Fiat-Anw/FMU_schematic_design-from-STM32H743IIT6/FMU_Base_board_Design/AD&IO_Port.kicad_sch

## KiCad design FMU_Base_board_Design/AD&IO_Port.kicad_sch (2024-08-14)

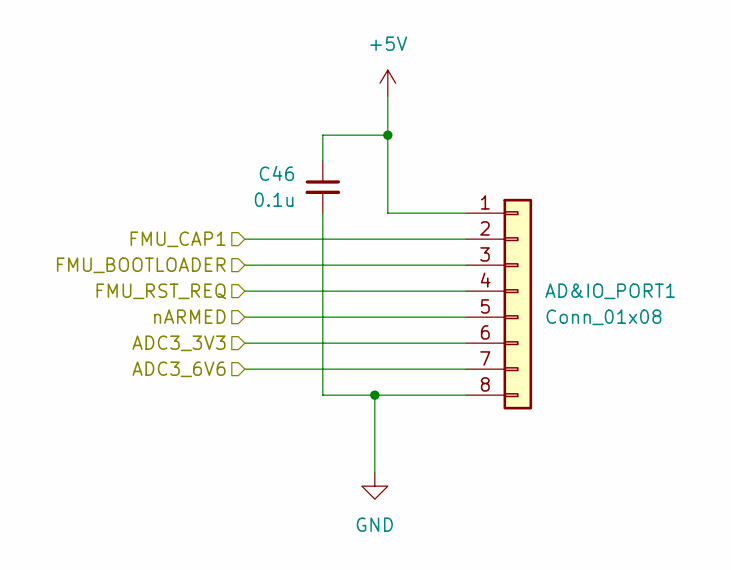
[picture p1: schematic AD&IO_Port.kicad_sch]

Parts:
AD&IO_PORT1: Conn_01x08; JST_GH_BM08B-GHS-TBT_1x08-1MP_P1.25mm_Vertical
C46: 0.1u; C_0402_1005Metric_Pad0.74x0.62mm_HandSolder

Connections:
+5V: AD&IO_PORT1.1, C46.1
ADC3_3V3: AD&IO_PORT1.6
ADC3_6V6: AD&IO_PORT1.7
FMU_BOOTLOADER: AD&IO_PORT1.3
FMU_CAP1: AD&IO_PORT1.2
FMU_RST_REQ: AD&IO_PORT1.4
GND: AD&IO_PORT1.8, C46.2
nARMED: AD&IO_PORT1.5
