Fiat-Anw/FMU_schematic_design-from-STM32H743IIT6/FMU_Base_board_Design/Barometer.kicad_sch

## KiCad design FMU_Base_board_Design/Barometer.kicad_sch (2024-08-14)

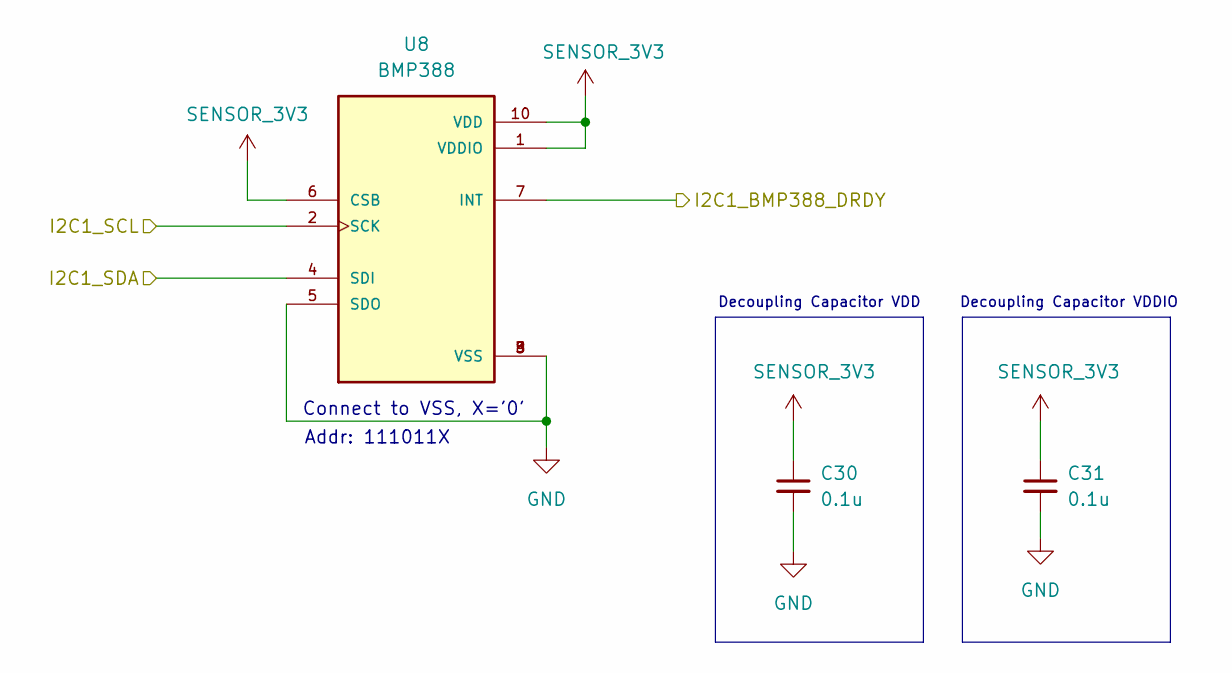
[picture p2: schematic Barometer.kicad_sch]

Parts:
C30, C31: 0.1u; C_0402_1005Metric_Pad0.74x0.62mm_HandSolder
U8: BMP388; PQFN50P200X200X80-10N; PARTREV 1.1

Connections:
GND: C30.2, C31.2, U8.3 (VSS), U8.5 (SDO), U8.8 (VSS), U8.9 (VSS)
I2C1_BMP388_DRDY: U8.7 (INT)
I2C1_SCL: U8.2 (SCK)
I2C1_SDA: U8.4 (SDI)
SENSOR_3V3: C30.1, C31.1, U8.1 (VDDIO), U8.6 (CSB), U8.10 (VDD)

Notes on the sheet:
Addr: 111011X
Connect to VSS, X='0'
Decoupling Capacitor VDD
Decoupling Capacitor VDDIO
