Fiat-Anw/FMU_schematic_design-from-STM32H743IIT6/FMU_Base_board_Design/CAN_Module1.kicad_sch

## KiCad design FMU_Base_board_Design/CAN_Module1.kicad_sch (2024-08-14)

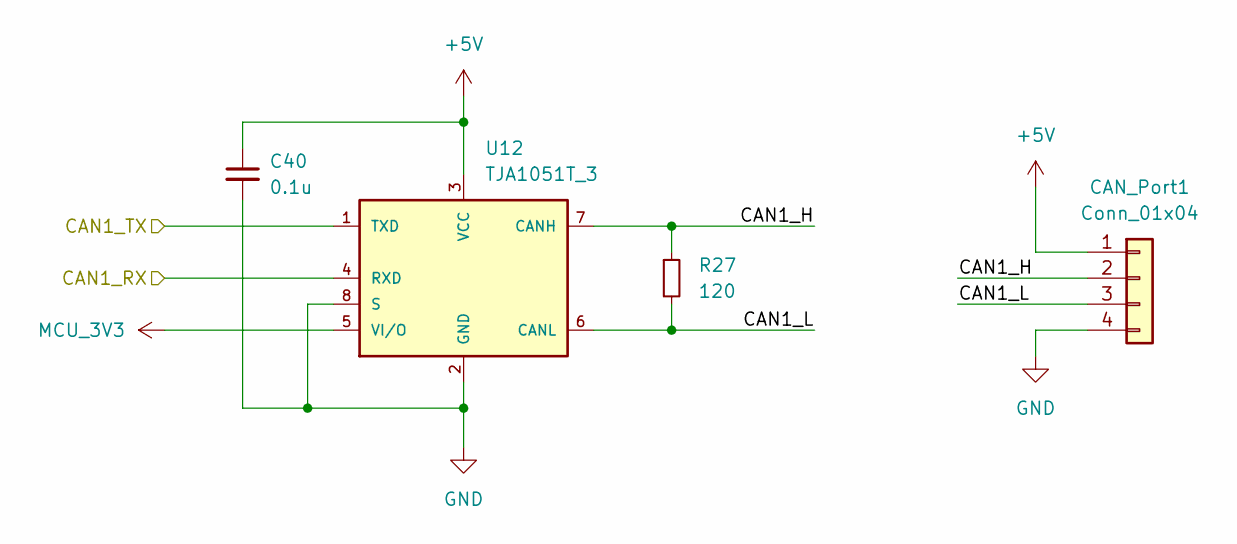
[picture p3: schematic CAN_Module1.kicad_sch]

Parts:
C40: 0.1u; C_0402_1005Metric_Pad0.74x0.62mm_HandSolder
CAN_Port1: Conn_01x04; JST_GH_BM04B-GHS-TBT_1x04-1MP_P1.25mm_Vertical
R27: 120; R_0402_1005Metric_Pad0.72x0.64mm_HandSolder
U12: TJA1051T_3; SOT96-1

Connections:
+5V: C40.1, CAN_Port1.1, U12.3 (VCC)
CAN1_H: CAN_Port1.2, R27.1, U12.7 (CANH)
CAN1_L: CAN_Port1.3, R27.2, U12.6 (CANL)
CAN1_RX: U12.4 (RXD)
CAN1_TX: U12.1 (TXD)
GND: C40.2, CAN_Port1.4, U12.2 (GND), U12.8 (S)
MCU_3V3: U12.5 (VI/O)
