Fiat-Anw/FMU_schematic_design-from-STM32H743IIT6/FMU_Base_board_Design/CAN_Module2.kicad_sch

## KiCad design FMU_Base_board_Design/CAN_Module2.kicad_sch (2024-08-14)

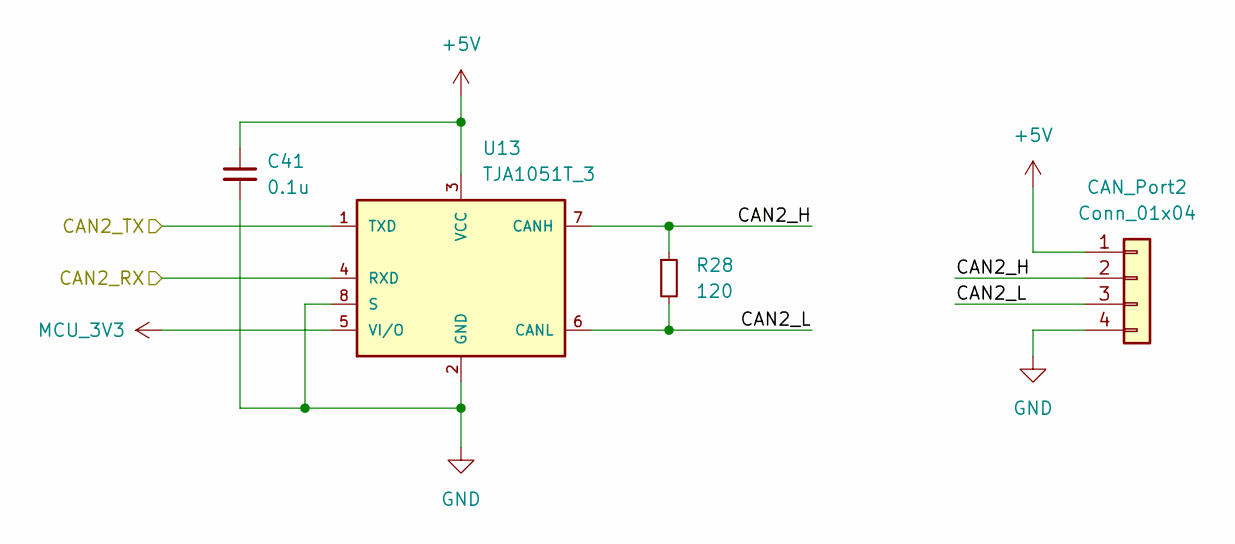
[picture p4: schematic CAN_Module2.kicad_sch]

Parts:
C41: 0.1u; C_0402_1005Metric_Pad0.74x0.62mm_HandSolder
CAN_Port2: Conn_01x04; JST_GH_BM04B-GHS-TBT_1x04-1MP_P1.25mm_Vertical
R28: 120; R_0402_1005Metric_Pad0.72x0.64mm_HandSolder
U13: TJA1051T_3; SOT96-1

Connections:
+5V: C41.1, CAN_Port2.1, U13.3 (VCC)
CAN2_H: CAN_Port2.2, R28.1, U13.7 (CANH)
CAN2_L: CAN_Port2.3, R28.2, U13.6 (CANL)
CAN2_RX: U13.4 (RXD)
CAN2_TX: U13.1 (TXD)
GND: C41.2, CAN_Port2.4, U13.2 (GND), U13.8 (S)
MCU_3V3: U13.5 (VI/O)
