Fiat-Anw/FMU_schematic_design-from-STM32H743IIT6/FMU_Base_board_Design/FMU_Debug.kicad_sch

## KiCad design FMU_Base_board_Design/FMU_Debug.kicad_sch (2024-08-14)

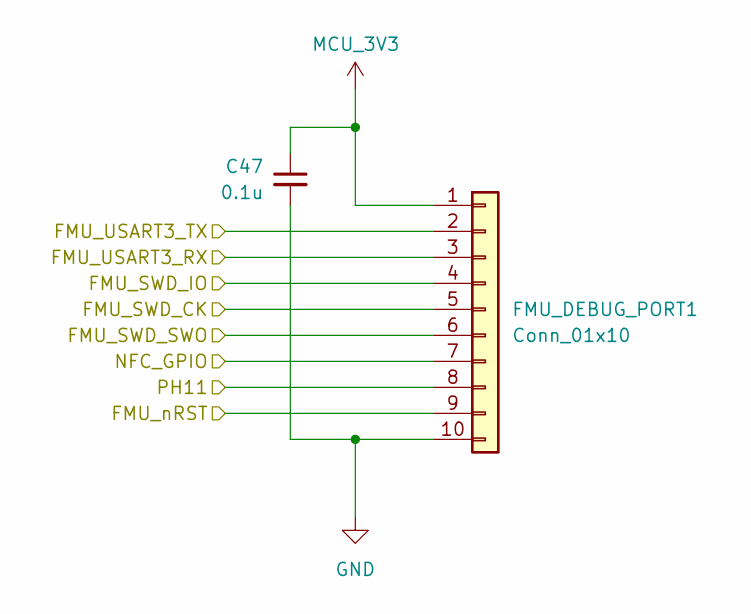
[picture p5: schematic FMU_Debug.kicad_sch]

Parts:
C47: 0.1u; C_0402_1005Metric_Pad0.74x0.62mm_HandSolder
FMU_DEBUG_PORT1: Conn_01x10; JST_SH_SM10B-SRSS-TB_1x10-1MP_P1.00mm_Horizontal

Connections:
FMU_SWD_CK: FMU_DEBUG_PORT1.5
FMU_SWD_IO: FMU_DEBUG_PORT1.4
FMU_SWD_SWO: FMU_DEBUG_PORT1.6
FMU_USART3_RX: FMU_DEBUG_PORT1.3
FMU_USART3_TX: FMU_DEBUG_PORT1.2
FMU_nRST: FMU_DEBUG_PORT1.9
GND: C47.2, FMU_DEBUG_PORT1.10
MCU_3V3: C47.1, FMU_DEBUG_PORT1.1
NFC_GPIO: FMU_DEBUG_PORT1.7
PH11: FMU_DEBUG_PORT1.8
