Fiat-Anw/FMU_schematic_design-from-STM32H743IIT6/FMU_Base_board_Design/FMU_PPM_IN_PWM.kicad_sch

## KiCad design FMU_Base_board_Design/FMU_PPM_IN_PWM.kicad_sch (2024-08-14)

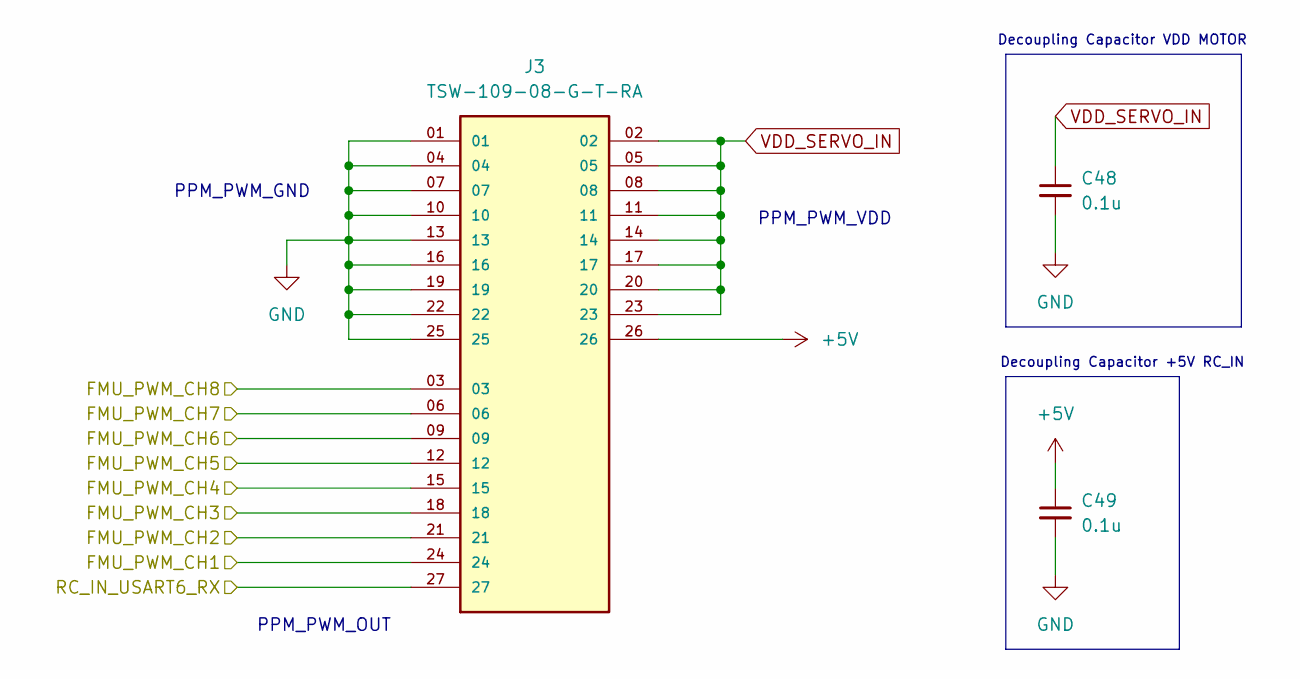
[picture p6: schematic FMU_PPM_IN_PWM.kicad_sch]

Parts:
C48, C49: 0.1u; C_0402_1005Metric_Pad0.74x0.62mm_HandSolder
J3: TSW-109-08-G-T-RA; SAMTEC_TSW-109-08-G-T-RA; PARTREV R

Connections:
+5V: C49.1, J3.26
FMU_PWM_CH1: J3.24
FMU_PWM_CH2: J3.21
FMU_PWM_CH3: J3.18
FMU_PWM_CH4: J3.15
FMU_PWM_CH5: J3.12
FMU_PWM_CH6: J3.09
FMU_PWM_CH7: J3.06
FMU_PWM_CH8: J3.03
GND: C48.2, C49.2, J3.01, J3.04, J3.07, J3.10, J3.13, J3.16, J3.19, J3.22, J3.25
RC_IN_USART6_RX: J3.27
VDD_SERVO_IN: C48.1, J3.02, J3.05, J3.08, J3.11, J3.14, J3.17, J3.20, J3.23

Notes on the sheet:
PPM_PWM_OUT
Decoupling Capacitor +5V RC_IN
PPM_PWM_VDD
PPM_PWM_GND
Decoupling Capacitor VDD MOTOR
