Fiat-Anw/FMU_schematic_design-from-STM32H743IIT6/FMU_Base_board_Design/FMU_PWM.kicad_sch

## KiCad design FMU_Base_board_Design/FMU_PWM.kicad_sch (2024-08-14)

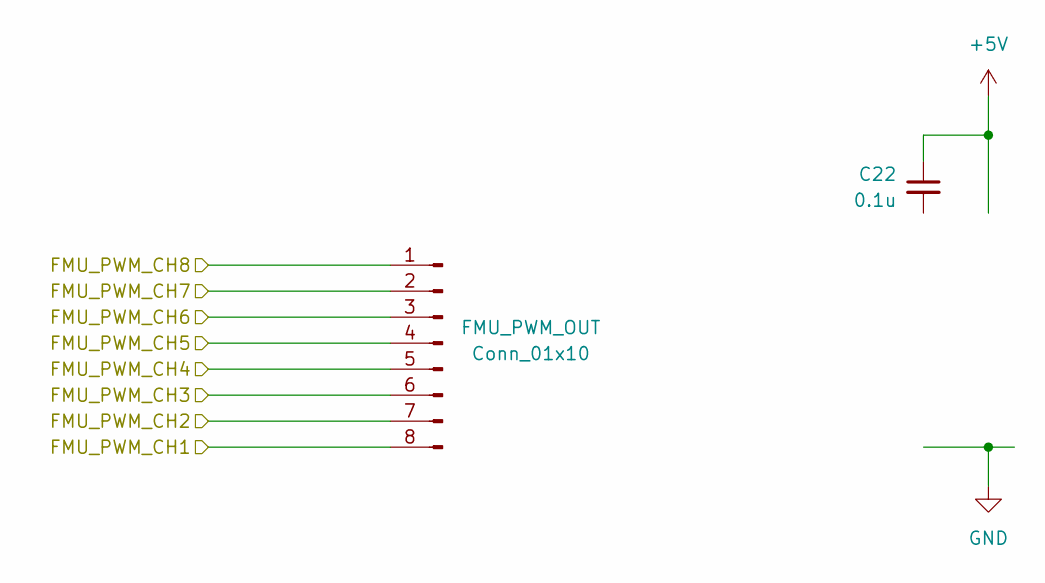
[picture p7: schematic FMU_PWM.kicad_sch]

Parts:
C22: 0.1u
FMU_PWM_OUT: Conn_01x10

Connections:
+5V: C22.1
FMU_PWM_CH1: FMU_PWM_OUT.8
FMU_PWM_CH2: FMU_PWM_OUT.7
FMU_PWM_CH3: FMU_PWM_OUT.6
FMU_PWM_CH4: FMU_PWM_OUT.5
FMU_PWM_CH5: FMU_PWM_OUT.4
FMU_PWM_CH6: FMU_PWM_OUT.3
FMU_PWM_CH7: FMU_PWM_OUT.2
FMU_PWM_CH8: FMU_PWM_OUT.1
