Fiat-Anw/FMU_schematic_design-from-STM32H743IIT6/FMU_Base_board_Design/FMU_Power_Supply.kicad_sch

## KiCad design FMU_Base_board_Design/FMU_Power_Supply.kicad_sch (2024-08-14)

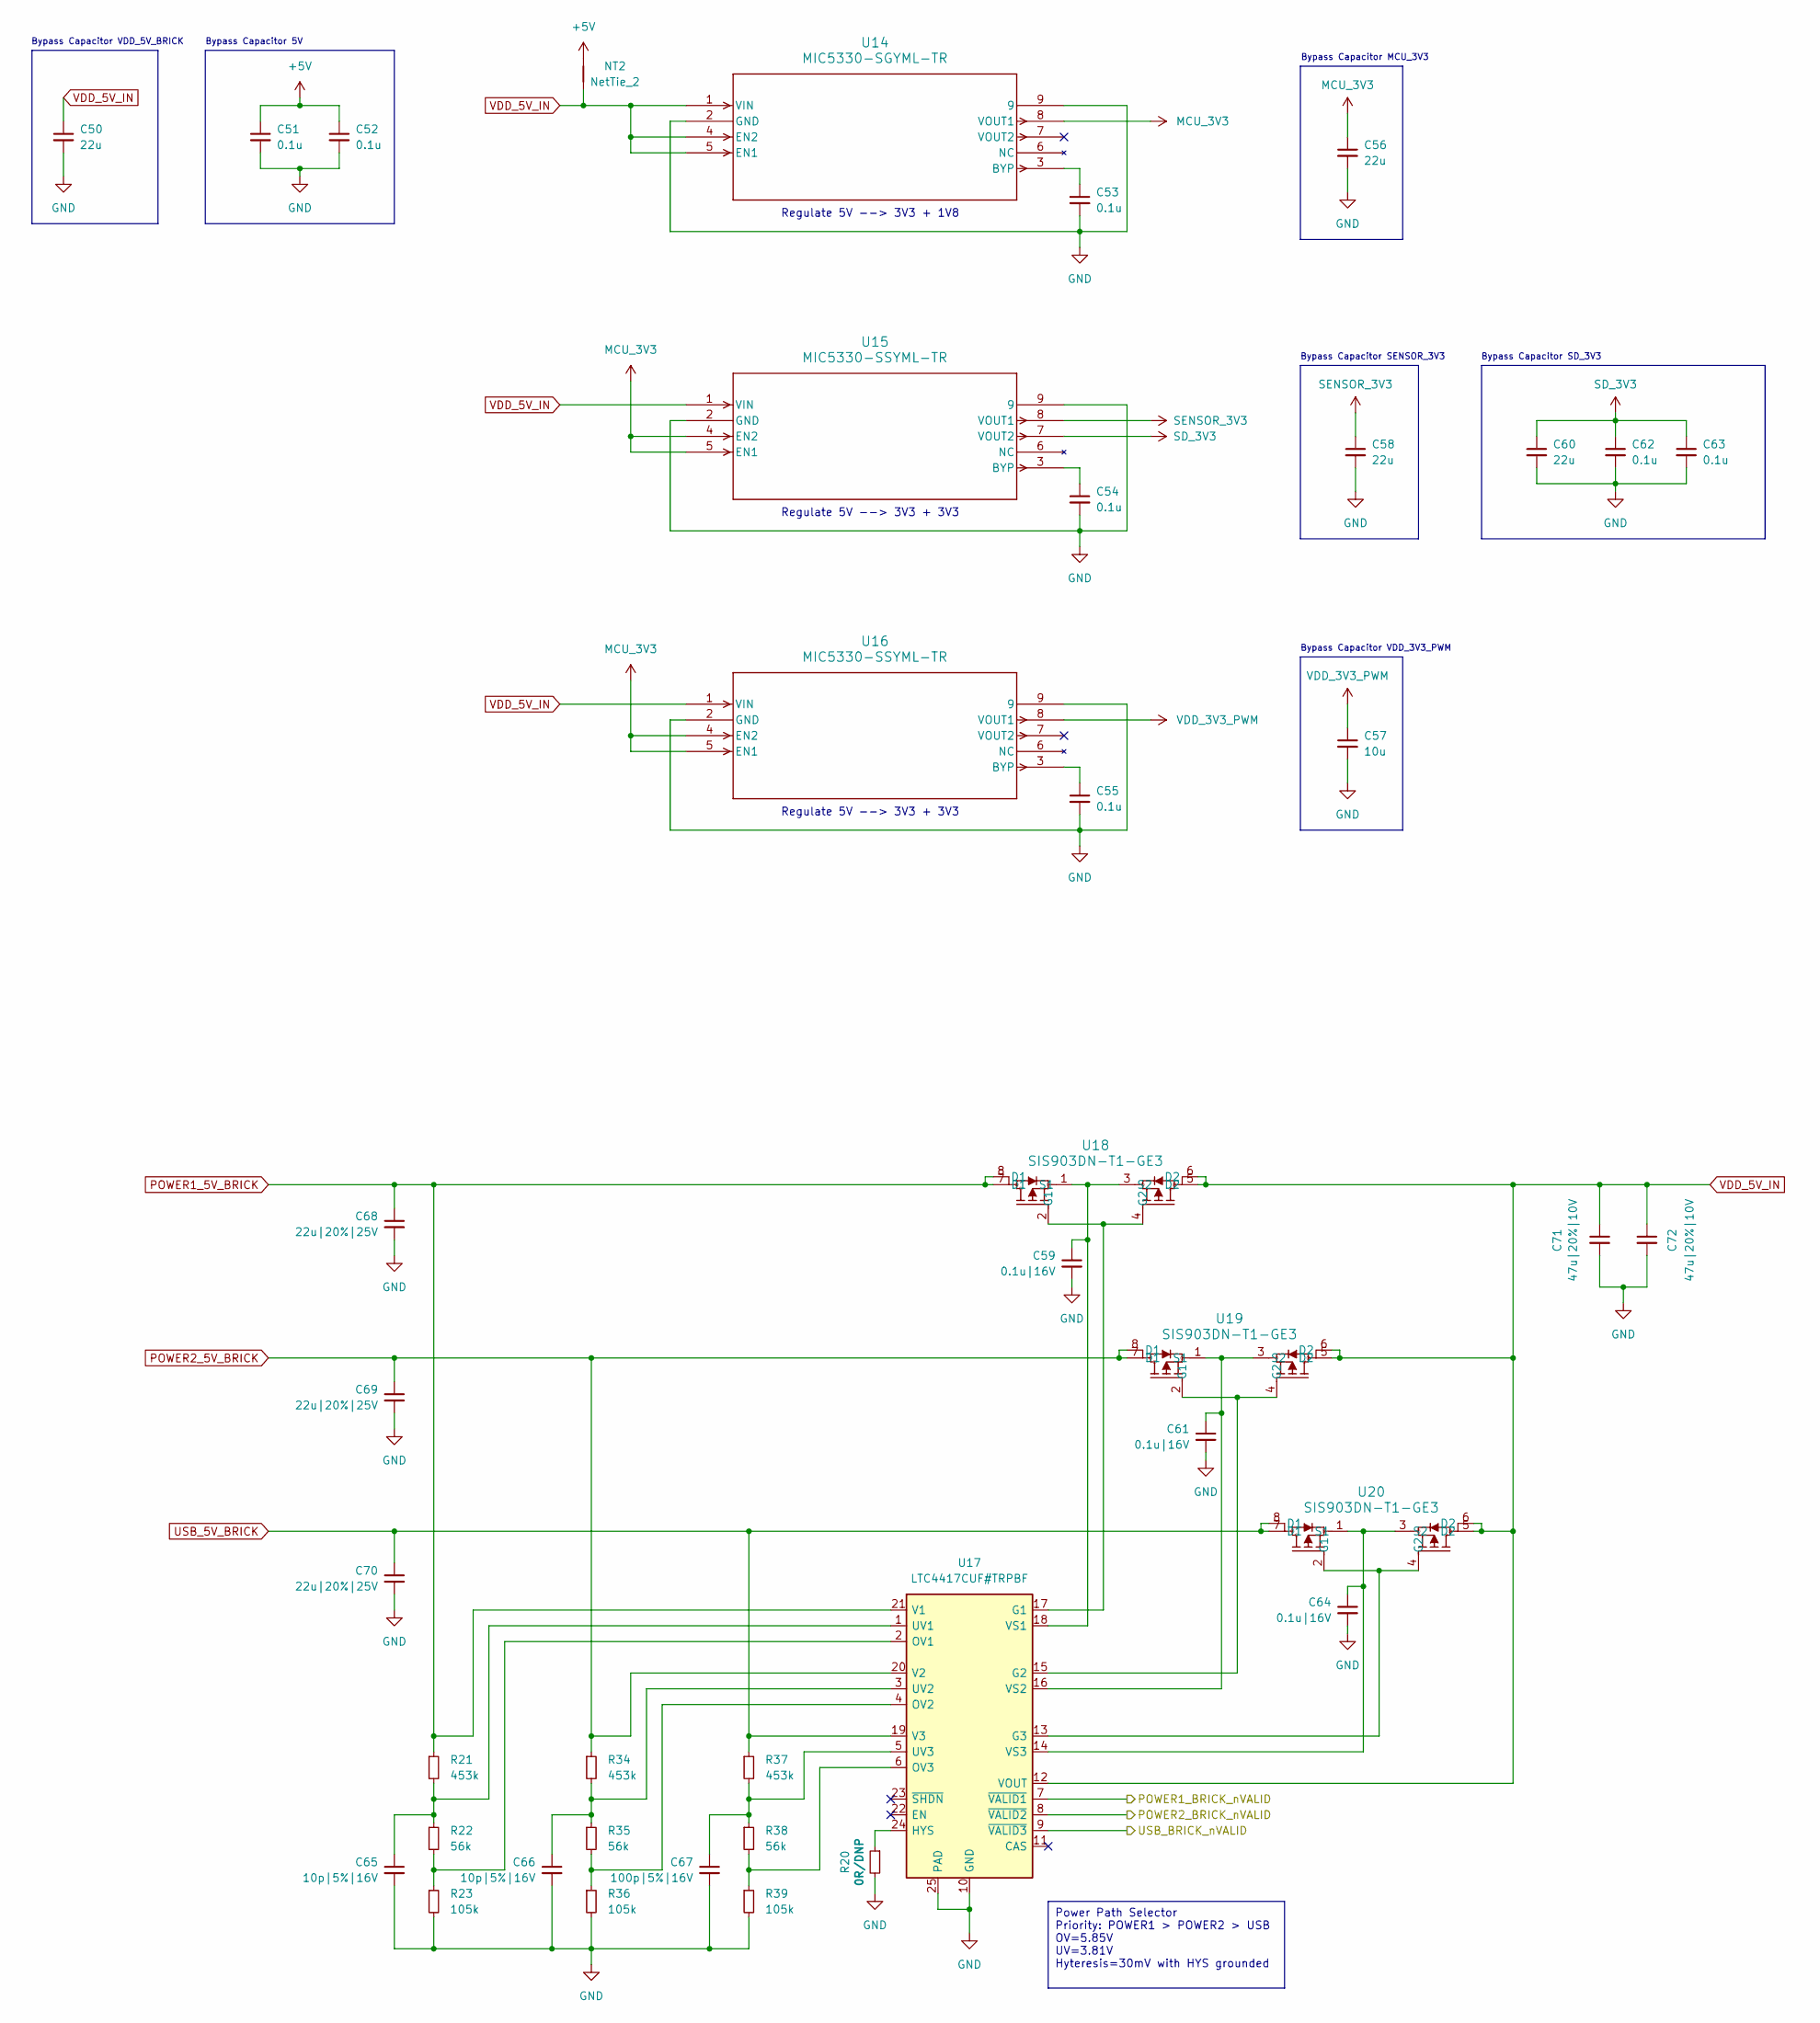
[picture p8: schematic FMU_Power_Supply.kicad_sch]

Parts:
C50, C56, C58, C60: 22u; C_0603_1608Metric_Pad1.08x0.95mm_HandSolder
C51, C52, C53, C54, C55, C62, C63: 0.1u; C_0402_1005Metric_Pad0.74x0.62mm_HandSolder
C57: 10u; C_0402_1005Metric_Pad0.74x0.62mm_HandSolder
C59, C61, C64: 0.1u|16V; C_0402_1005Metric_Pad0.74x0.62mm_HandSolder
C65, C66: 10p|5%|16V; C_0402_1005Metric_Pad0.74x0.62mm_HandSolder
C67: 100p|5%|16V; C_0402_1005Metric_Pad0.74x0.62mm_HandSolder
C68, C69, C70: 22u|20%|25V; C_0603_1608Metric_Pad1.08x0.95mm_HandSolder
C71, C72: 47u|20%|10V; C_0805_2012Metric_Pad1.18x1.45mm_HandSolder
NT2: NetTie_2; NetTie-2_SMD_Pad2.0mm
R20: 0R/DNP; R_0402_1005Metric_Pad0.72x0.64mm_HandSolder
R21, R34, R37: 453k; R_0402_1005Metric_Pad0.72x0.64mm_HandSolder
R22, R35, R38: 56k; R_0402_1005Metric_Pad0.72x0.64mm_HandSolder
R23, R36, R39: 105k; R_0402_1005Metric_Pad0.72x0.64mm_HandSolder
U14: MIC5330-SGYML-TR; MLF-8_ML_MCH
U15, U16: MIC5330-SSYML-TR; MLF-8_ML_MCH
U17: LTC4417CUF#TRPBF; QFN-24-1EP_4x4mm_P0.5mm_EP2.6x2.6mm
U18, U19, U20: SIS903DN-T1-GE3; MOSFET_DN-T1-GE3_VIS

Connections:
+5V: C51.1, C52.1, NT2.1
GND: C50.2, C51.2, C52.2, C53.2, C54.2, C55.2, C56.2, C57.2, C58.2, C59.2, C60.2, C61.2, C62.2, C63.2, C64.2, C65.2, C66.2, C67.2, C68.2, C69.2, C70.2, C71.2, C72.2, R20.2, R23.2, R36.2, R39.2, U14.2 (GND), U14.9, U15.2 (GND), U15.9, U16.2 (GND), U16.9, U17.10 (GND), U17.25 (PAD)
MCU_3V3: C56.1, U14.8 (VOUT1), U15.4 (EN2), U15.5 (EN1), U16.4 (EN2), U16.5 (EN1)
unnamed: C53.1, U14.3 (BYP)
unnamed: C54.1, U15.3 (BYP)
unnamed: C55.1, U16.3 (BYP)
unnamed: C59.1, U17.18 (VS1), U18.1 (S1), U18.3 (S2)
unnamed: C61.1, U17.16 (VS2), U19.1 (S1), U19.3 (S2)
unnamed: C64.1, U17.14 (VS3), U20.1 (S1), U20.3 (S2)
unnamed: C65.1, R21.2, R22.1, U17.1 (UV1)
unnamed: C66.1, R34.2, R35.1, U17.3 (UV2)
unnamed: C67.1, R37.2, R38.1, U17.5 (UV3)
unnamed: R20.1, U17.24 (HYS)
unnamed: R22.2, R23.1, U17.2 (OV1)
unnamed: R35.2, R36.1, U17.4 (OV2)
unnamed: R38.2, R39.1, U17.6 (OV3)
unnamed: U17.13 (G3), U20.2 (G1), U20.4 (G2)
unnamed: U17.15 (G2), U19.2 (G1), U19.4 (G2)
unnamed: U17.17 (G1), U18.2 (G1), U18.4 (G2)
POWER1_5V_BRICK: C68.1, R21.1, U17.21 (V1), U18.7 (D1), U18.8 (D1)
POWER1_BRICK_nVALID: U17.7 (~VALID1)
POWER2_5V_BRICK: C69.1, R34.1, U17.20 (V2), U19.7 (D1), U19.8 (D1)
POWER2_BRICK_nVALID: U17.8 (~VALID2)
SD_3V3: C60.1, C62.1, C63.1, U15.7 (VOUT2)
SENSOR_3V3: C58.1, U15.8 (VOUT1)
USB_5V_BRICK: C70.1, R37.1, U17.19 (V3), U20.7 (D1), U20.8 (D1)
USB_BRICK_nVALID: U17.9 (~VALID3)
VDD_3V3_PWM: C57.1, U16.8 (VOUT1)
VDD_5V_IN: C50.1, C71.1, C72.1, NT2.2, U14.1 (VIN), U14.4 (EN2), U14.5 (EN1), U15.1 (VIN), U16.1 (VIN), U17.12 (VOUT), U18.5 (D2), U18.6 (D2), U19.5 (D2), U19.6 (D2), U20.5 (D2), U20.6 (D2)

Notes on the sheet:
Power Path Selector Priority: POWER1 > POWER2 > USB OV=5.85V UV=3.81V Hyteresis=30mV with HYS grounded
Bypass Capacitor MCU_3V3
Bypass Capacitor VDD_5V_BRICK
Bypass Capacitor 5V
Bypass Capacitor SD_3V3
Bypass Capacitor VDD_3V3_PWM
Bypass Capacitor SENSOR_3V3
Regulate 5V --> 3V3 + 1V8
Regulate 5V --> 3V3 + 3V3
