Fiat-Anw/FMU_schematic_design-from-STM32H743IIT6/FMU_Base_board_Design/FRAM.kicad_sch

## KiCad design FMU_Base_board_Design/FRAM.kicad_sch (2024-08-14)

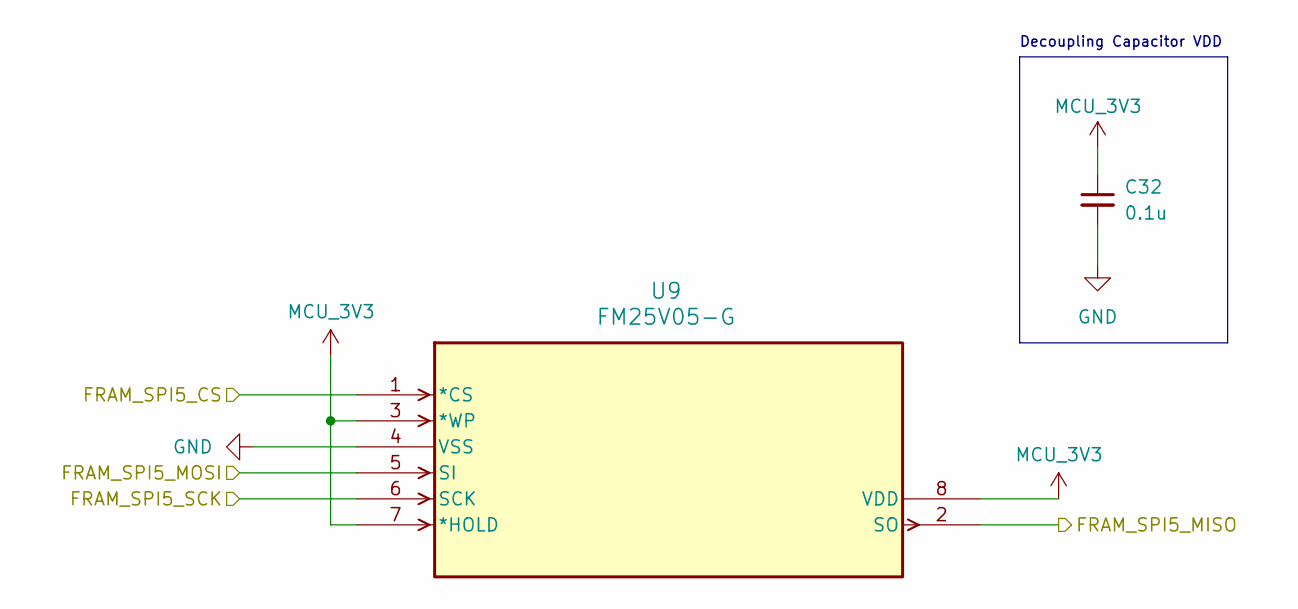
[picture p9: schematic FRAM.kicad_sch]

Parts:
C32: 0.1u; C_0402_1005Metric_Pad0.74x0.62mm_HandSolder
U9: FM25V05-G; SOIC-8

Connections:
FRAM_SPI5_CS: U9.1 (*CS)
FRAM_SPI5_MISO: U9.2 (SO)
FRAM_SPI5_MOSI: U9.5 (SI)
FRAM_SPI5_SCK: U9.6 (SCK)
GND: C32.2, U9.4 (VSS)
MCU_3V3: C32.1, U9.3 (*WP), U9.7 (*HOLD), U9.8 (VDD)

Notes on the sheet:
Decoupling Capacitor VDD
