Fiat-Anw/FMU_schematic_design-from-STM32H743IIT6/FMU_Base_board_Design/GPS_Module1.kicad_sch

## KiCad design FMU_Base_board_Design/GPS_Module1.kicad_sch (2024-08-14)

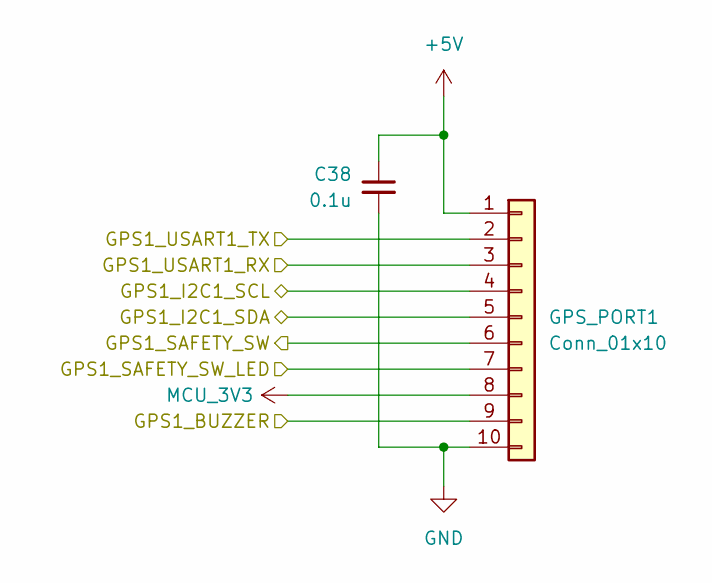
[picture p10: schematic GPS_Module1.kicad_sch]

Parts:
C38: 0.1u; C_0402_1005Metric_Pad0.74x0.62mm_HandSolder
GPS_PORT1: Conn_01x10; JST_GH_BM10B-GHS-TBT_1x10-1MP_P1.25mm_Vertical

Connections:
+5V: C38.1, GPS_PORT1.1
GND: C38.2, GPS_PORT1.10
GPS1_BUZZER: GPS_PORT1.9
GPS1_I2C1_SCL: GPS_PORT1.4
GPS1_I2C1_SDA: GPS_PORT1.5
GPS1_SAFETY_SW: GPS_PORT1.6
GPS1_SAFETY_SW_LED: GPS_PORT1.7
GPS1_USART1_RX: GPS_PORT1.3
GPS1_USART1_TX: GPS_PORT1.2
MCU_3V3: GPS_PORT1.8
