Fiat-Anw/FMU_schematic_design-from-STM32H743IIT6/FMU_Base_board_Design/GPS_Module2.kicad_sch

## KiCad design FMU_Base_board_Design/GPS_Module2.kicad_sch (2024-08-14)

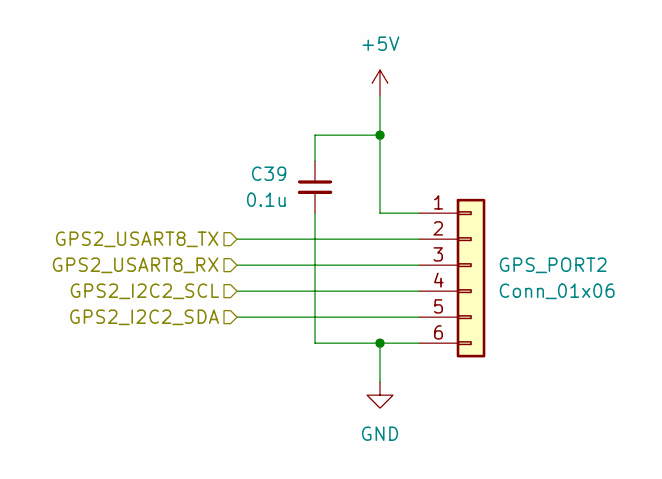
[picture p11: schematic GPS_Module2.kicad_sch]

Parts:
C39: 0.1u; C_0402_1005Metric_Pad0.74x0.62mm_HandSolder
GPS_PORT2: Conn_01x06; JST_GH_BM06B-GHS-TBT_1x06-1MP_P1.25mm_Vertical

Connections:
+5V: C39.1, GPS_PORT2.1
GND: C39.2, GPS_PORT2.6
GPS2_I2C2_SCL: GPS_PORT2.4
GPS2_I2C2_SDA: GPS_PORT2.5
GPS2_USART8_RX: GPS_PORT2.3
GPS2_USART8_TX: GPS_PORT2.2
