Fiat-Anw/FMU_schematic_design-from-STM32H743IIT6/FMU_Base_board_Design/I2C_Port.kicad_sch

## KiCad design FMU_Base_board_Design/I2C_Port.kicad_sch (2024-08-14)

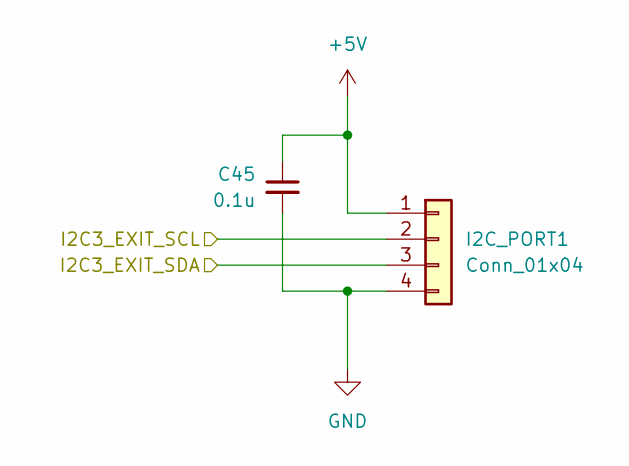
[picture p12: schematic I2C_Port.kicad_sch]

Parts:
C45: 0.1u; C_0402_1005Metric_Pad0.74x0.62mm_HandSolder
I2C_PORT1: Conn_01x04; JST_GH_BM04B-GHS-TBT_1x04-1MP_P1.25mm_Vertical

Connections:
+5V: C45.1, I2C_PORT1.1
GND: C45.2, I2C_PORT1.4
I2C3_EXIT_SCL: I2C_PORT1.2
I2C3_EXIT_SDA: I2C_PORT1.3
