Fiat-Anw/FMU_schematic_design-from-STM32H743IIT6/FMU_Base_board_Design/IMU.kicad_sch

## KiCad design FMU_Base_board_Design/IMU.kicad_sch (2024-08-14)

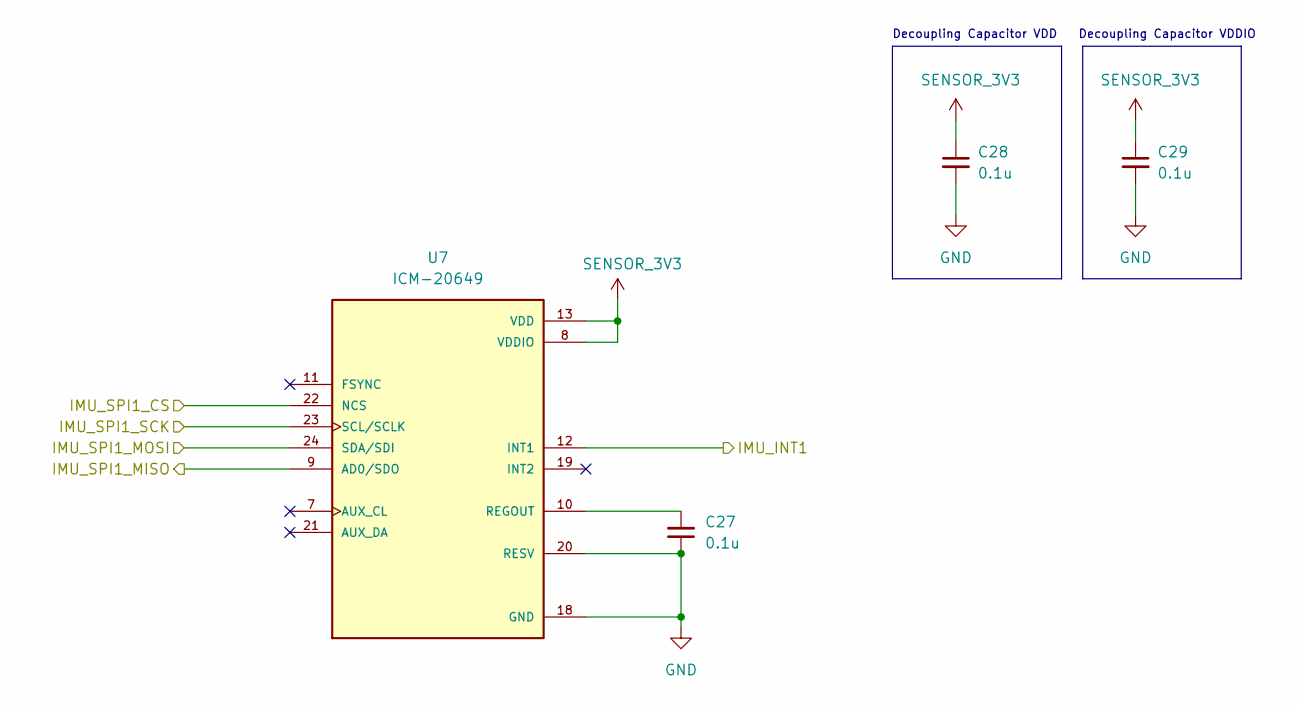
[picture p13: schematic IMU.kicad_sch]

Parts:
C27, C28, C29: 0.1u; C_0402_1005Metric_Pad0.74x0.62mm_HandSolder
U7: ICM-20649; QFN40P300X300X95-24N

Connections:
GND: C27.1, C28.2, C29.2, U7.18 (GND), U7.20 (RESV)
IMU_INT1: U7.12 (INT1)
IMU_SPI1_CS: U7.22 (NCS)
IMU_SPI1_MISO: U7.9 (AD0/SDO)
IMU_SPI1_MOSI: U7.24 (SDA/SDI)
IMU_SPI1_SCK: U7.23 (SCL/SCLK)
unnamed: C27.2, U7.10 (REGOUT)
SENSOR_3V3: C28.1, C29.1, U7.8 (VDDIO), U7.13 (VDD)

Notes on the sheet:
Decoupling Capacitor VDD
Decoupling Capacitor VDDIO
