Fiat-Anw/FMU_schematic_design-from-STM32H743IIT6/FMU_Base_board_Design/MCU.kicad_sch

## KiCad design FMU_Base_board_Design/MCU.kicad_sch (2024-08-14)

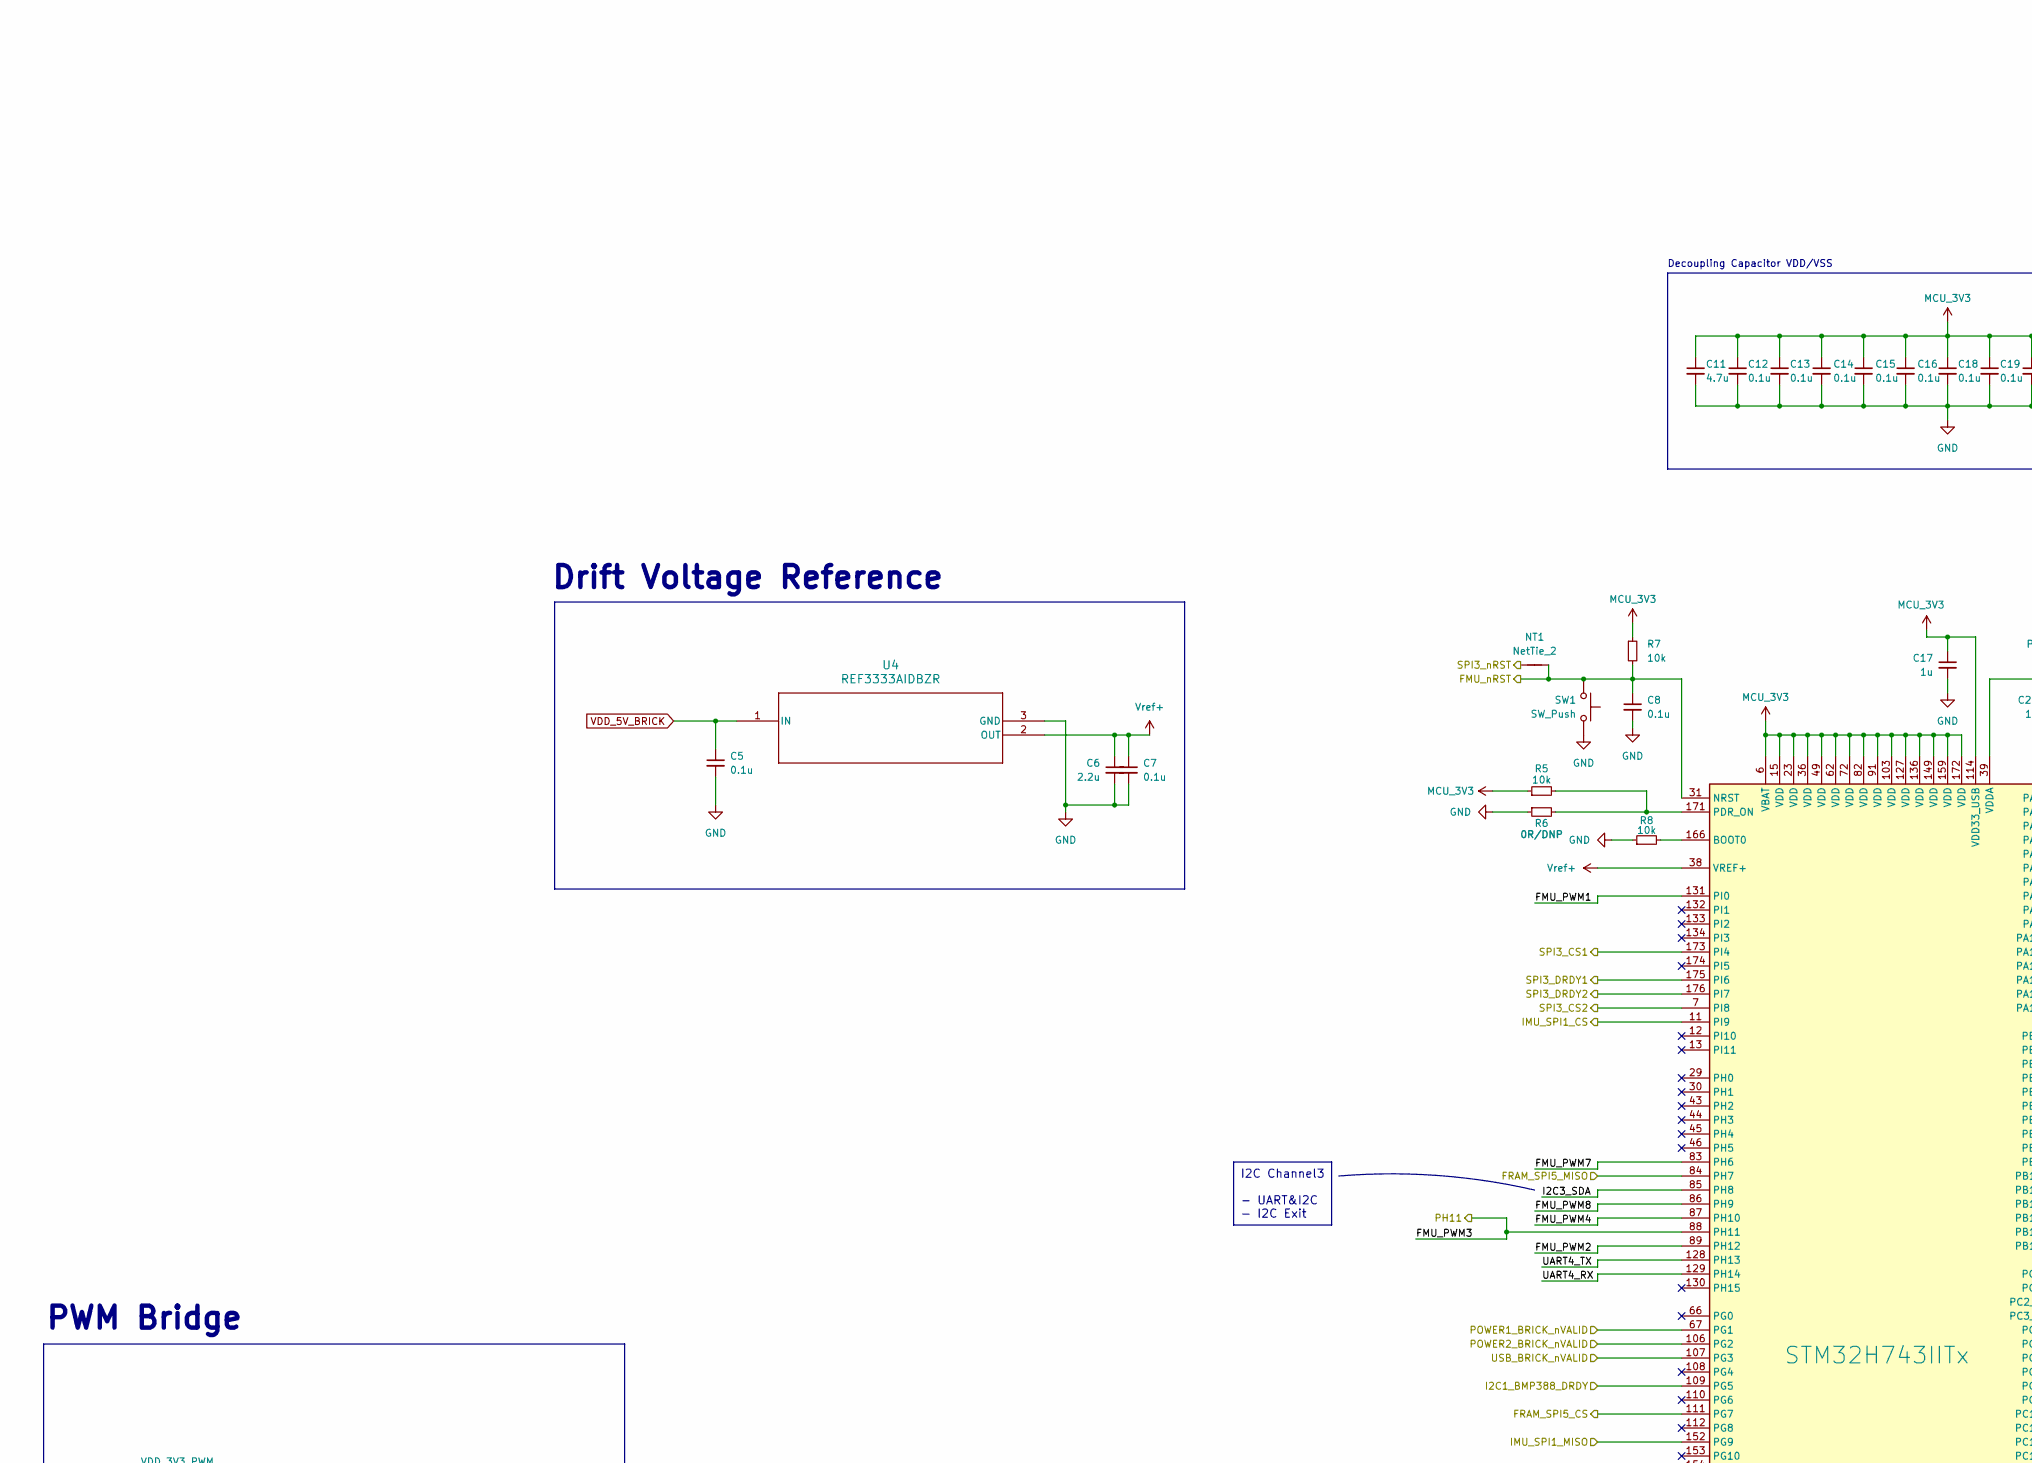
[picture p14: schematic MCU.kicad_sch, part in row 1, column 1]

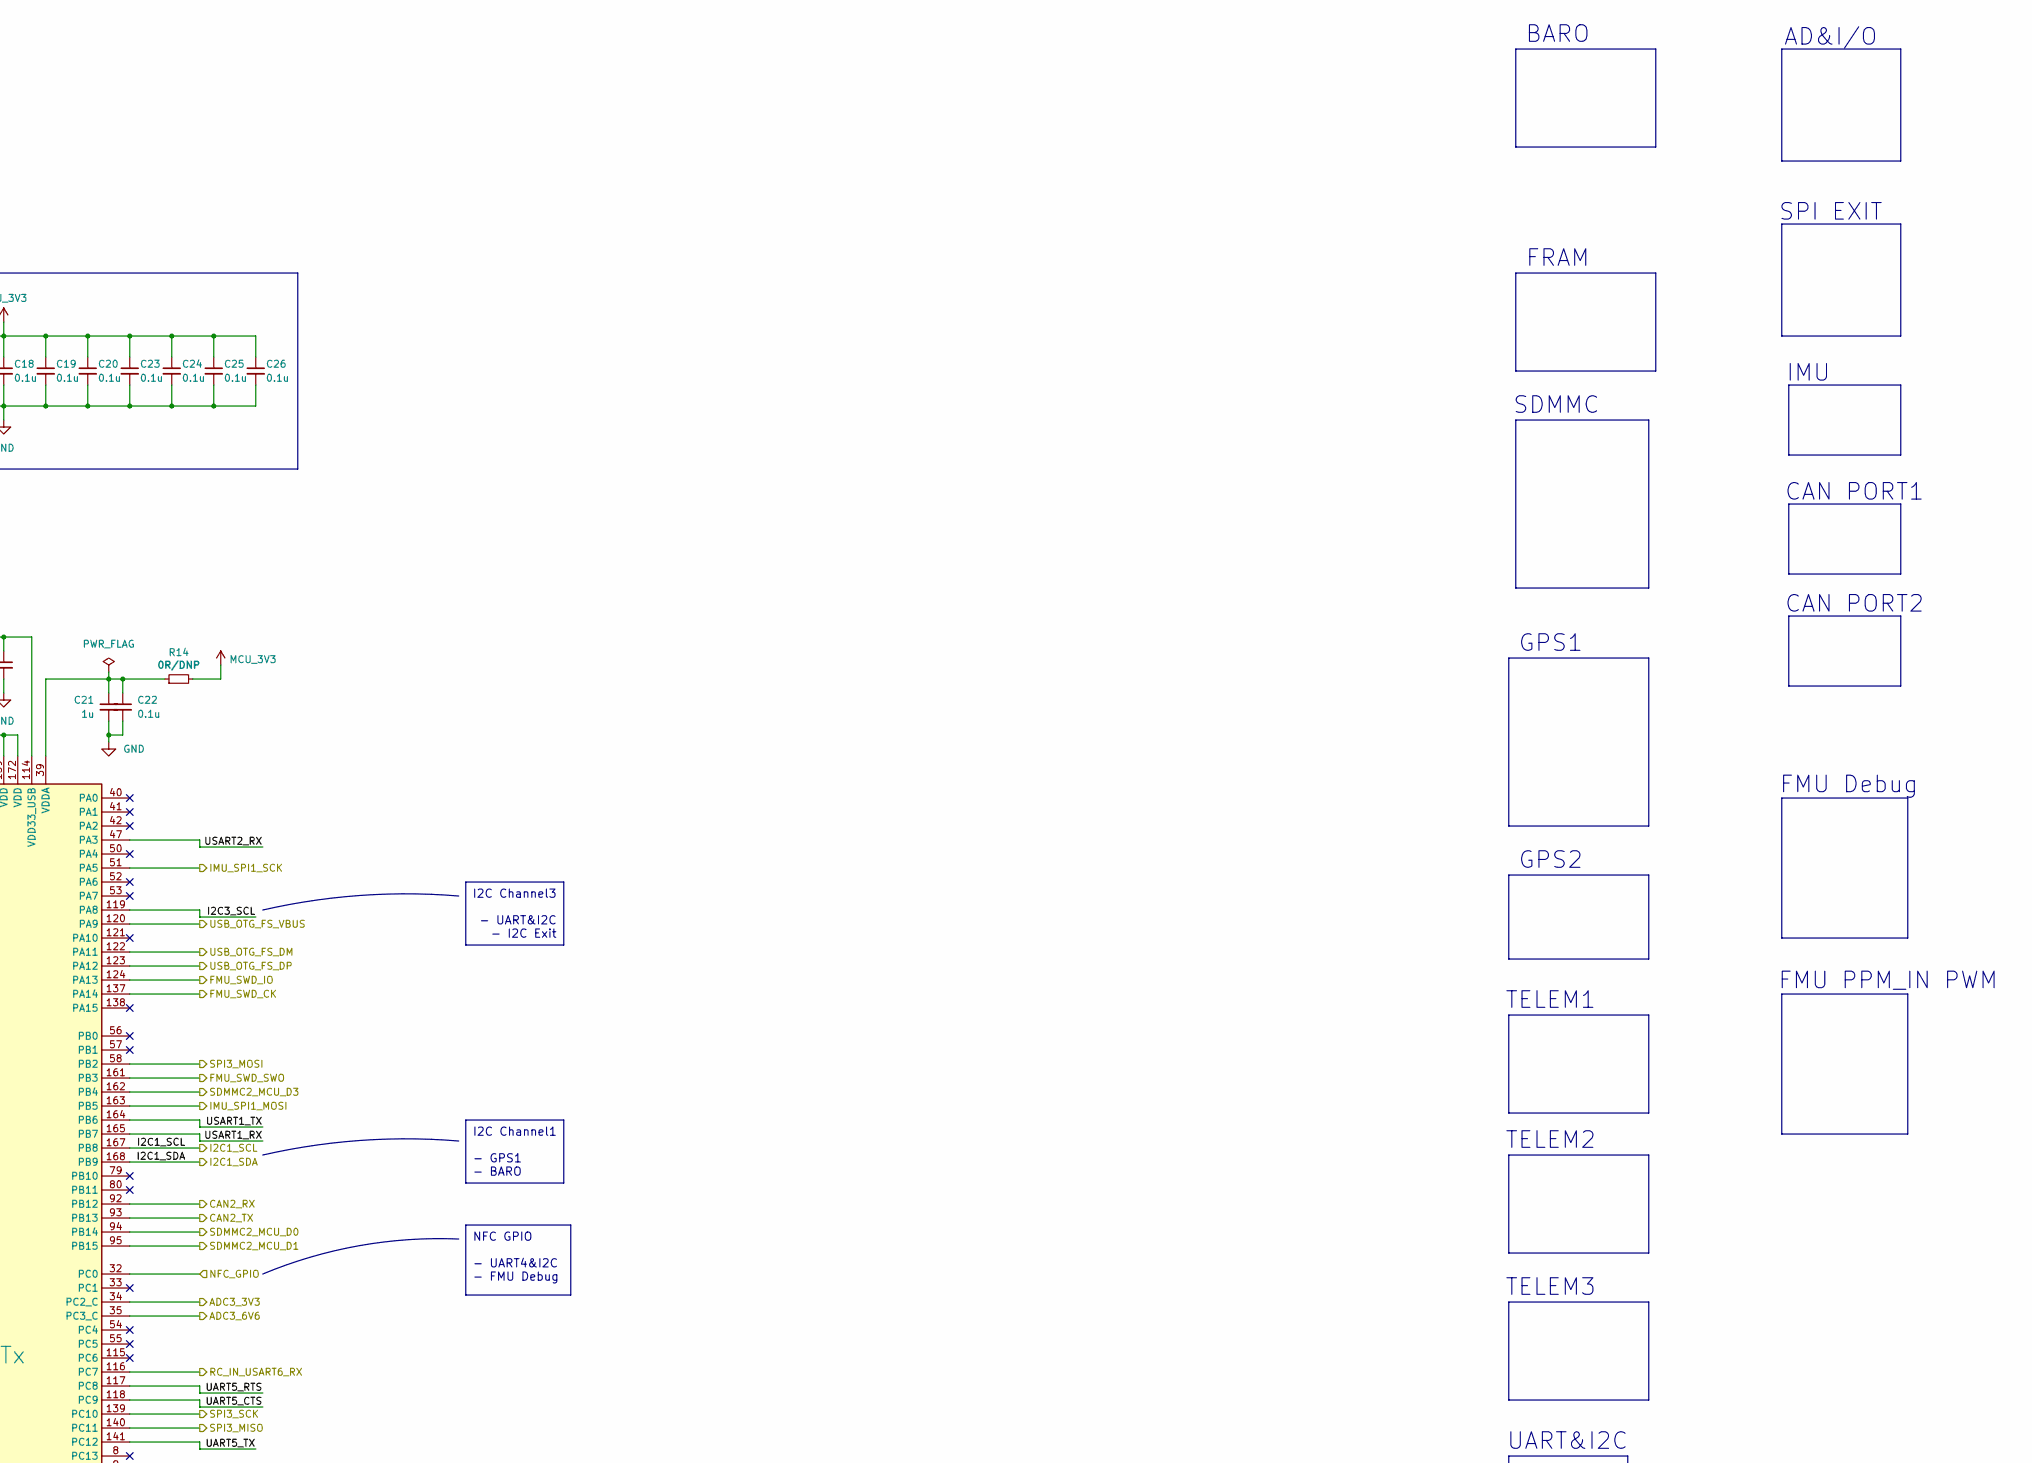
[picture p15: schematic MCU.kicad_sch, part in row 1, column 2]

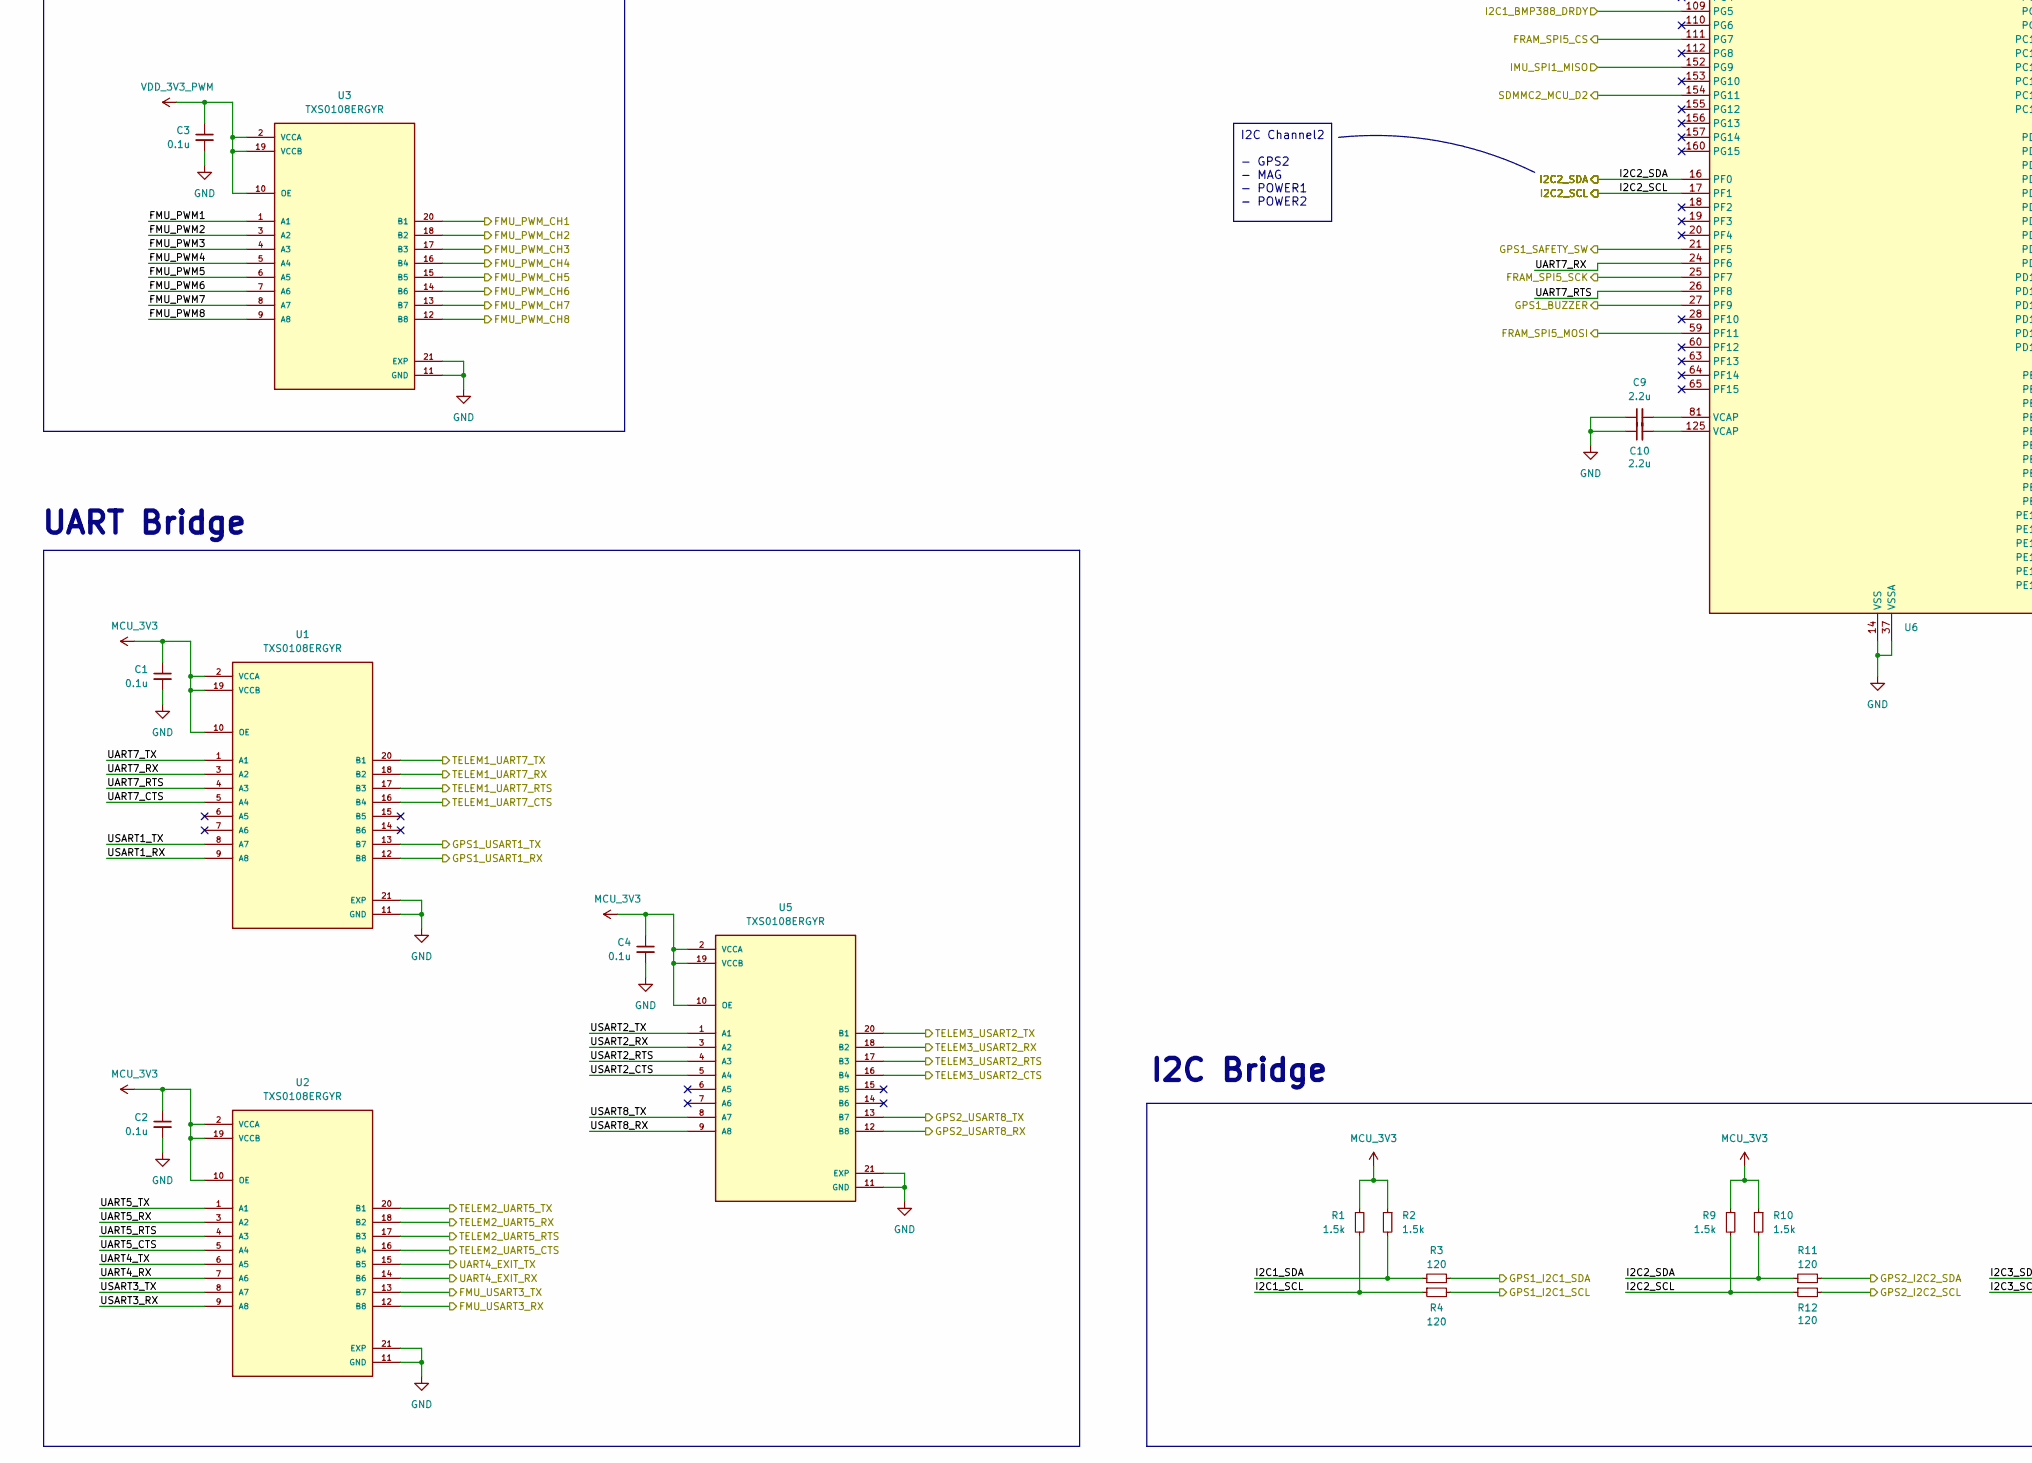
[picture p16: schematic MCU.kicad_sch, part in row 2, column 1]

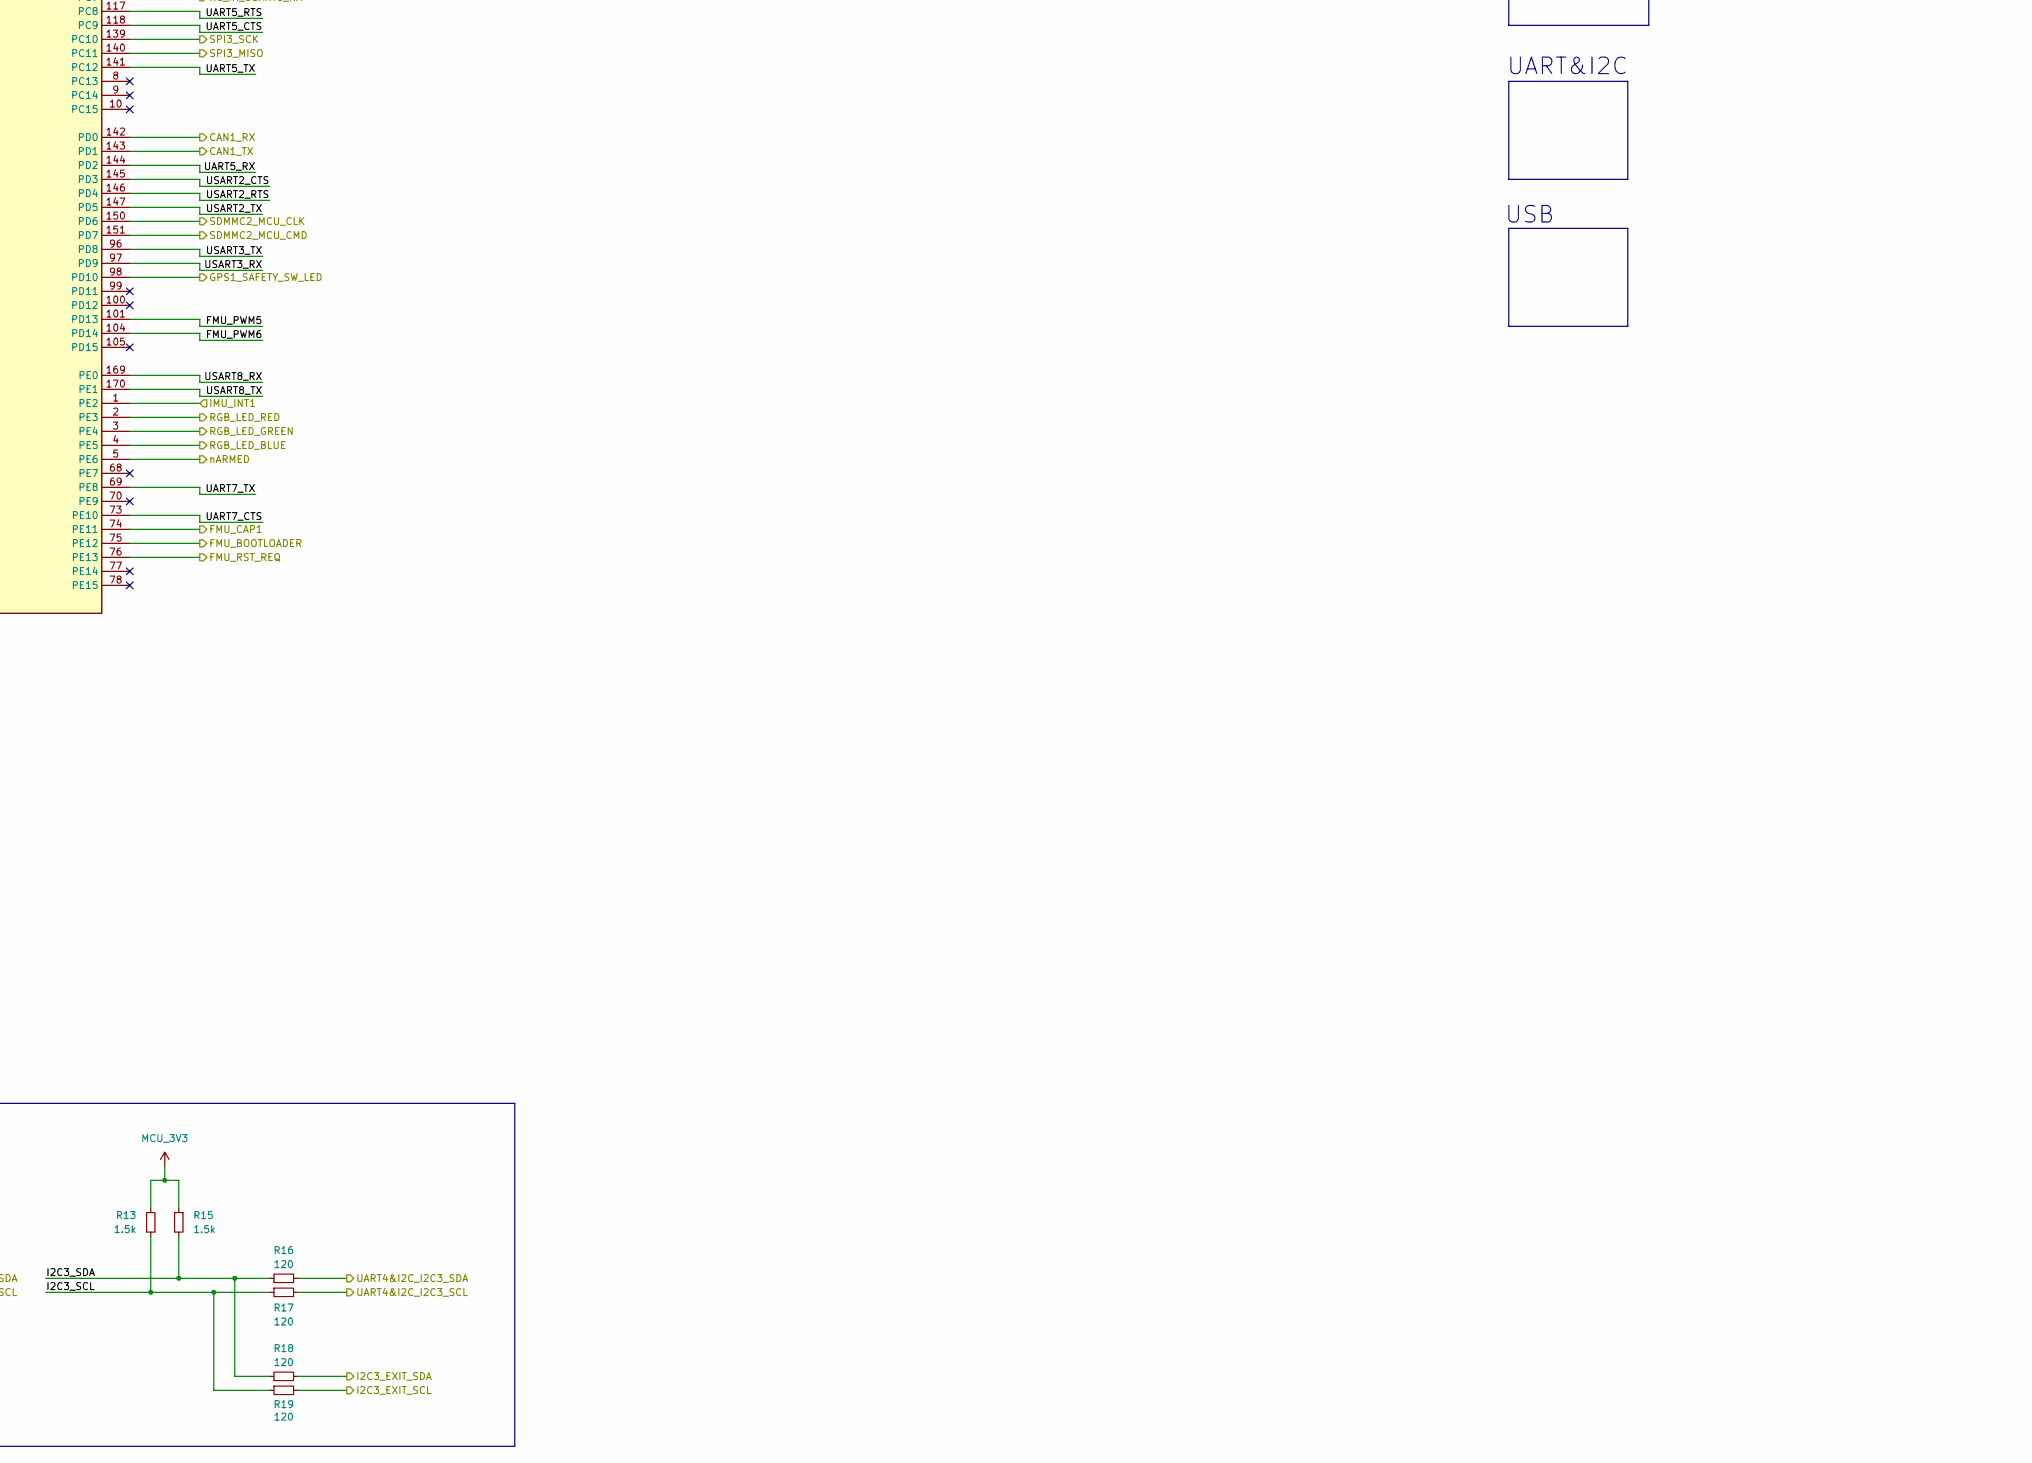
[picture p17: schematic MCU.kicad_sch, part in row 2, column 2]

Parts:
C1, C2, C3, C4, C5, C7, C8, C12, C13, C14, C15, C16, C18, C19, C20, C22, C23, C24, C25, C26: 0.1u; C_0402_1005Metric_Pad0.74x0.62mm_HandSolder
C6, C9, C10: 2.2u; C_0402_1005Metric_Pad0.74x0.62mm_HandSolder
C11: 4.7u; C_0402_1005Metric_Pad0.74x0.62mm_HandSolder
C17, C21: 1u; C_0402_1005Metric_Pad0.74x0.62mm_HandSolder
NT1: NetTie_2
R1, R2, R9, R10, R13, R15: 1.5k; R_0402_1005Metric_Pad0.72x0.64mm_HandSolder
R3, R4, R11, R12, R16, R17, R18, R19: 120; R_0402_1005Metric_Pad0.72x0.64mm_HandSolder
R5, R7, R8: 10k; R_0402_1005Metric_Pad0.72x0.64mm_HandSolder
R6, R14: 0R/DNP; R_0402_1005Metric_Pad0.72x0.64mm_HandSolder
SW1: SW_Push; SW_TL6340AF160Q
U1, U2, U3, U5: TXS0108ERGYR; IC_TXS0108ERGYR; PARTREV H
U4: REF3333AIDBZR; DBZ3
U6: STM32H743IITx; LQFP-176_24x24mm_P0.5mm

Connections:
ADC3_3V3: U6.34 (PC2_C)
ADC3_6V6: U6.35 (PC3_C)
CAN1_RX: U6.142 (PD0)
CAN1_TX: U6.143 (PD1)
CAN2_RX: U6.92 (PB12)
CAN2_TX: U6.93 (PB13)
FMU_BOOTLOADER: U6.75 (PE12)
FMU_CAP1: U6.74 (PE11)
FMU_PWM1: U3.1 (A1), U6.131 (PI0)
FMU_PWM2: U3.3 (A2), U6.89 (PH12)
FMU_PWM3: U3.4 (A3), U6.88 (PH11)
FMU_PWM4: U3.5 (A4), U6.87 (PH10)
FMU_PWM5: U3.6 (A5), U6.101 (PD13)
FMU_PWM6: U3.7 (A6), U6.104 (PD14)
FMU_PWM7: U3.8 (A7), U6.83 (PH6)
FMU_PWM8: U3.9 (A8), U6.86 (PH9)
FMU_PWM_CH1: U3.20 (B1)
FMU_PWM_CH2: U3.18 (B2)
FMU_PWM_CH3: U3.17 (B3)
FMU_PWM_CH4: U3.16 (B4)
FMU_PWM_CH5: U3.15 (B5)
FMU_PWM_CH6: U3.14 (B6)
FMU_PWM_CH7: U3.13 (B7)
FMU_PWM_CH8: U3.12 (B8)
FMU_RST_REQ: U6.76 (PE13)
FMU_SWD_CK: U6.137 (PA14)
FMU_SWD_IO: U6.124 (PA13)
FMU_SWD_SWO: U6.161 (PB3)
FMU_USART3_RX: U2.12 (B8)
FMU_USART3_TX: U2.13 (B7)
FMU_nRST: C8.1, NT1.2, R7.2, SW1.2, U6.31 (NRST)
FRAM_SPI5_CS: U6.111 (PG7)
FRAM_SPI5_MISO: U6.84 (PH7)
FRAM_SPI5_MOSI: U6.59 (PF11)
FRAM_SPI5_SCK: U6.25 (PF7)
GND: C1.2, C2.2, C3.2, C4.2, C5.2, C6.2, C7.2, C8.2, C9.1, C10.1, C11.2, C12.2, C13.2, C14.2, C15.2, C16.2, C17.2, C18.2, C19.2, C20.2, C21.2, C22.2, C23.2, C24.2, C25.2, C26.2, R6.1, R8.1, SW1.1, U1.11 (GND), U1.21 (EXP), U2.11 (GND), U2.21 (EXP), U3.11 (GND), U3.21 (EXP), U4.3 (GND), U5.11 (GND), U5.21 (EXP), U6.14 (VSS), U6.22 (VSS), U6.37 (VSSA), U6.48 (VSS), U6.61 (VSS), U6.71 (VSS), U6.90 (VSS), U6.102 (VSS), U6.113 (VSS), U6.126 (VSS), U6.135 (VSS), U6.148 (VSS), U6.158 (VSS)
GPS1_BUZZER: U6.27 (PF9)
GPS1_I2C1_SCL: R4.2
GPS1_I2C1_SDA: R3.2
GPS1_SAFETY_SW: U6.21 (PF5)
GPS1_SAFETY_SW_LED: U6.98 (PD10)
GPS1_USART1_RX: U1.12 (B8)
GPS1_USART1_TX: U1.13 (B7)
GPS2_I2C2_SCL: R12.2
GPS2_I2C2_SDA: R11.2
GPS2_USART8_RX: U5.12 (B8)
GPS2_USART8_TX: U5.13 (B7)
I2C1_BMP388_DRDY: U6.109 (PG5)
I2C1_SCL: R1.2, R4.1, U6.167 (PB8)
I2C1_SDA: R2.2, R3.1, U6.168 (PB9)
I2C2_SCL: R9.2, R12.1, U6.17 (PF1)
I2C2_SDA: R10.2, R11.1, U6.16 (PF0)
I2C3_EXIT_SCL: R19.2
I2C3_EXIT_SDA: R18.2
I2C3_SCL: R13.2, R17.1, R19.1, U6.119 (PA8)
I2C3_SDA: R15.2, R16.1, R18.1, U6.85 (PH8)
IMU_INT1: U6.1 (PE2)
IMU_SPI1_CS: U6.11 (PI9)
IMU_SPI1_MISO: U6.152 (PG9)
IMU_SPI1_MOSI: U6.163 (PB5)
IMU_SPI1_SCK: U6.51 (PA5)
MCU_3V3: C1.1, C2.1, C4.1, C11.1, C12.1, C13.1, C14.1, C15.1, C16.1, C17.1, C18.1, C19.1, C20.1, C23.1, C24.1, C25.1, C26.1, R1.1, R2.1, R5.1, R7.1, R9.1, R10.1, R13.1, R14.2, R15.1, U1.2 (VCCA), U1.10 (OE), U1.19 (VCCB), U2.2 (VCCA), U2.10 (OE), U2.19 (VCCB), U5.2 (VCCA), U5.10 (OE), U5.19 (VCCB), U6.6 (VBAT), U6.15 (VDD), U6.23 (VDD), U6.36 (VDD), U6.49 (VDD), U6.62 (VDD), U6.72 (VDD), U6.82 (VDD), U6.91 (VDD), U6.103 (VDD), U6.114 (VDD33_USB), U6.127 (VDD), U6.136 (VDD), U6.149 (VDD), U6.159 (VDD), U6.172 (VDD)
NFC_GPIO: U6.32 (PC0)
unnamed: C9.2, U6.81 (VCAP)
unnamed: C10.2, U6.125 (VCAP)
unnamed: C21.1, C22.1, R14.1, U6.39 (VDDA)
unnamed: R5.2, R6.2, U6.171 (PDR_ON)
unnamed: R8.2, U6.166 (BOOT0)
POWER1_BRICK_nVALID: U6.67 (PG1)
POWER2_BRICK_nVALID: U6.106 (PG2)
RC_IN_USART6_RX: U6.116 (PC7)
RGB_LED_BLUE: U6.4 (PE5)
RGB_LED_GREEN: U6.3 (PE4)
RGB_LED_RED: U6.2 (PE3)
SDMMC2_MCU_CLK: U6.150 (PD6)
SDMMC2_MCU_CMD: U6.151 (PD7)
SDMMC2_MCU_D0: U6.94 (PB14)
SDMMC2_MCU_D1: U6.95 (PB15)
SDMMC2_MCU_D2: U6.154 (PG11)
SDMMC2_MCU_D3: U6.162 (PB4)
SPI3_CS1: U6.173 (PI4)
SPI3_CS2: U6.7 (PI8)
SPI3_DRDY1: U6.175 (PI6)
SPI3_DRDY2: U6.176 (PI7)
SPI3_MISO: U6.140 (PC11)
SPI3_MOSI: U6.58 (PB2)
SPI3_SCK: U6.139 (PC10)
SPI3_nRST: NT1.1
TELEM1_UART7_CTS: U1.16 (B4)
TELEM1_UART7_RTS: U1.17 (B3)
TELEM1_UART7_RX: U1.18 (B2)
TELEM1_UART7_TX: U1.20 (B1)
TELEM2_UART5_CTS: U2.16 (B4)
TELEM2_UART5_RTS: U2.17 (B3)
TELEM2_UART5_RX: U2.18 (B2)
TELEM2_UART5_TX: U2.20 (B1)
TELEM3_USART2_CTS: U5.16 (B4)
TELEM3_USART2_RTS: U5.17 (B3)
TELEM3_USART2_RX: U5.18 (B2)
TELEM3_USART2_TX: U5.20 (B1)
UART4&I2C_I2C3_SCL: R17.2
UART4&I2C_I2C3_SDA: R16.2
UART4_EXIT_RX: U2.14 (B6)
UART4_EXIT_TX: U2.15 (B5)
UART4_RX: U2.7 (A6), U6.129 (PH14)
UART4_TX: U2.6 (A5), U6.128 (PH13)
UART5_CTS: U2.5 (A4), U6.118 (PC9)
UART5_RTS: U2.4 (A3), U6.117 (PC8)
UART5_RX: U2.3 (A2), U6.144 (PD2)
UART5_TX: U2.1 (A1), U6.141 (PC12)
UART7_CTS: U1.5 (A4), U6.73 (PE10)
UART7_RTS: U1.4 (A3), U6.26 (PF8)
UART7_RX: U1.3 (A2), U6.24 (PF6)
UART7_TX: U1.1 (A1), U6.69 (PE8)
USART1_RX: U1.9 (A8), U6.165 (PB7)
USART1_TX: U1.8 (A7), U6.164 (PB6)
USART2_CTS: U5.5 (A4), U6.145 (PD3)
USART2_RTS: U5.4 (A3), U6.146 (PD4)
USART2_RX: U5.3 (A2), U6.47 (PA3)
USART2_TX: U5.1 (A1), U6.147 (PD5)
USART3_RX: U2.9 (A8), U6.97 (PD9)
USART3_TX: U2.8 (A7), U6.96 (PD8)
USART8_RX: U5.9 (A8), U6.169 (PE0)
USART8_TX: U5.8 (A7), U6.170 (PE1)
USB_BRICK_nVALID: U6.107 (PG3)
USB_OTG_FS_DM: U6.122 (PA11)
USB_OTG_FS_DP: U6.123 (PA12)
USB_OTG_FS_VBUS: U6.120 (PA9)
VDD_3V3_PWM: C3.1, U3.2 (VCCA), U3.10 (OE), U3.19 (VCCB)
VDD_5V_BRICK: C5.1, U4.1 (IN)
Vref+: C6.1, C7.1, U4.2 (OUT), U6.38 (VREF+)
nARMED: U6.5 (PE6)

Notes on the sheet:
I2C Channel3 - UART&I2C - I2C Exit
I2C Channel1 - GPS1 - BARO
I2C Channel2 - GPS2 - MAG - POWER1 - POWER2
NFC GPIO - UART4&I2C - FMU Debug
IMU
GPS2
BARO
GPS1
Drift Voltage Reference
SDMMC
UART&I2C
PWM Bridge
TELEM2
AD&I/O
FRAM
TELEM3
USB
SPI EXIT
UART Bridge
I2C Bridge
CAN PORT2
Decoupling Capacitor VDD/VSS
FMU Debug
FMU PPM_IN PWM
CAN PORT1
TELEM1
