Fiat-Anw/FMU_schematic_design-from-STM32H743IIT6/FMU_Base_board_Design/Magnetometer.kicad_sch

## KiCad design FMU_Base_board_Design/Magnetometer.kicad_sch (2024-08-14)

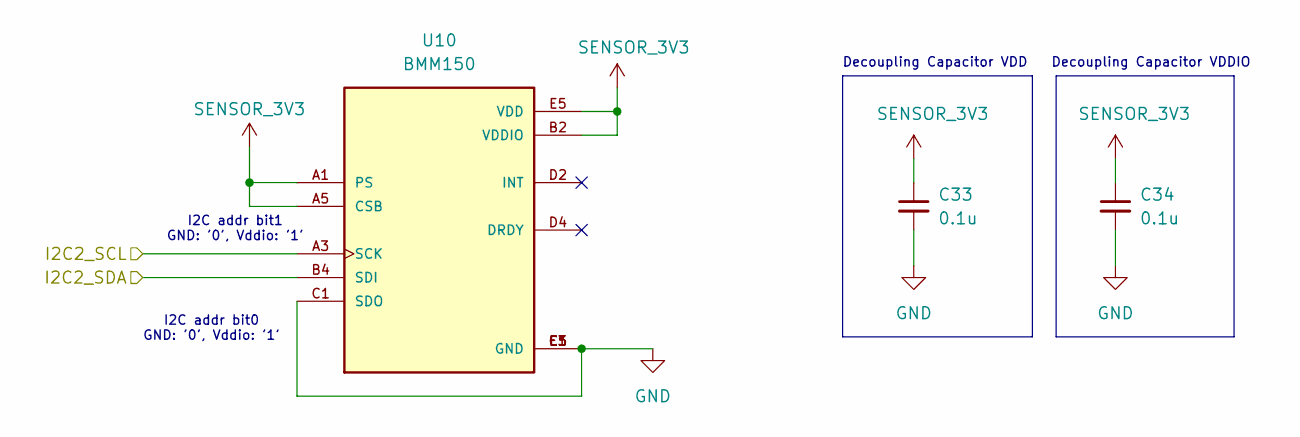
[picture p18: schematic Magnetometer.kicad_sch]

Parts:
C33, C34: 0.1u; C_0402_1005Metric_Pad0.74x0.62mm_HandSolder
U10: BMM150; XDCR_BMM150

Connections:
GND: C33.2, C34.2, U10.C1 (SDO), U10.C5 (GND), U10.E1 (GND), U10.E3 (GND)
I2C2_SCL: U10.A3 (SCK)
I2C2_SDA: U10.B4 (SDI)
SENSOR_3V3: C33.1, C34.1, U10.A1 (PS), U10.A5 (CSB), U10.B2 (VDDIO), U10.E5 (VDD)

Notes on the sheet:
I2C addr bit1 GND: '0', Vddio: '1'
Decoupling Capacitor VDDIO
I2C addr bit0 GND: '0', Vddio: '1'
Decoupling Capacitor VDD
