Fiat-Anw/FMU_schematic_design-from-STM32H743IIT6/FMU_Base_board_Design/MicroSD Connector.kicad_sch

## KiCad design FMU_Base_board_Design/MicroSD Connector.kicad_sch (2024-08-14)

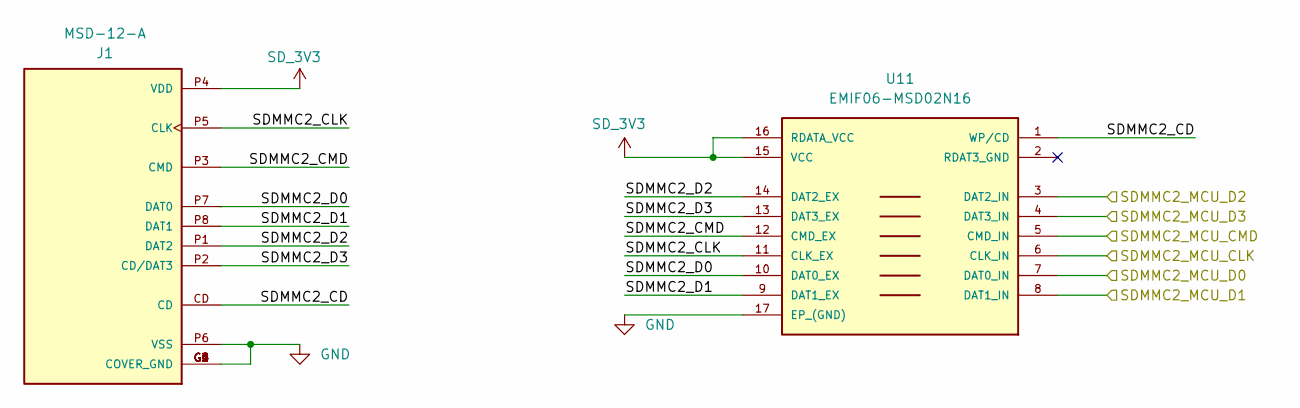
[picture p19: schematic MicroSD Connector.kicad_sch]

Parts:
J1: MSD-12-A; CUI_MSD-12-A; PARTREV 1.0
U11: EMIF06-MSD02N16; EMIF06MSD02N16; MOUSER_PART_NUMBER 511-EMIF06-MSD02N16

Connections:
GND: J1.G1 (COVER_GND), J1.G2 (COVER_GND), J1.G3 (COVER_GND), J1.G4 (COVER_GND), J1.G5 (COVER_GND), J1.G6 (COVER_GND), J1.P6 (VSS), U11.17 (EP_(GND))
SDMMC2_CD: J1.CD, U11.1 (WP/CD)
SDMMC2_CLK: J1.P5 (CLK), U11.11 (CLK_EX)
SDMMC2_CMD: J1.P3 (CMD), U11.12 (CMD_EX)
SDMMC2_D0: J1.P7 (DAT0), U11.10 (DAT0_EX)
SDMMC2_D1: J1.P8 (DAT1), U11.9 (DAT1_EX)
SDMMC2_D2: J1.P1 (DAT2), U11.14 (DAT2_EX)
SDMMC2_D3: J1.P2 (CD/DAT3), U11.13 (DAT3_EX)
SDMMC2_MCU_CLK: U11.6 (CLK_IN)
SDMMC2_MCU_CMD: U11.5 (CMD_IN)
SDMMC2_MCU_D0: U11.7 (DAT0_IN)
SDMMC2_MCU_D1: U11.8 (DAT1_IN)
SDMMC2_MCU_D2: U11.3 (DAT2_IN)
SDMMC2_MCU_D3: U11.4 (DAT3_IN)
SD_3V3: J1.P4 (VDD), U11.15 (VCC), U11.16 (RDATA_VCC)
