Fiat-Anw/FMU_schematic_design-from-STM32H743IIT6/FMU_Base_board_Design/RC_IN_Port.kicad_sch

## KiCad design FMU_Base_board_Design/RC_IN_Port.kicad_sch (2024-08-14)

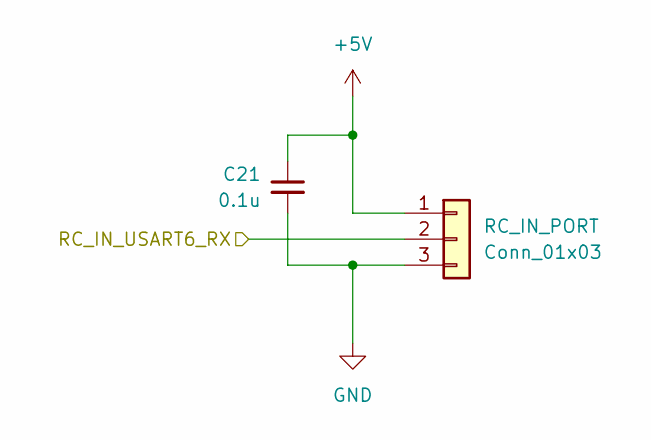
[picture p20: schematic RC_IN_Port.kicad_sch]

Parts:
C21: 0.1u
RC_IN_PORT: Conn_01x03

Connections:
+5V: C21.1, RC_IN_PORT.1
GND: C21.2, RC_IN_PORT.3
RC_IN_USART6_RX: RC_IN_PORT.2
