Fiat-Anw/FMU_schematic_design-from-STM32H743IIT6/FMU_Base_board_Design/RGB LED Onboard.kicad_sch

## KiCad design FMU_Base_board_Design/RGB LED Onboard.kicad_sch (2024-08-14)

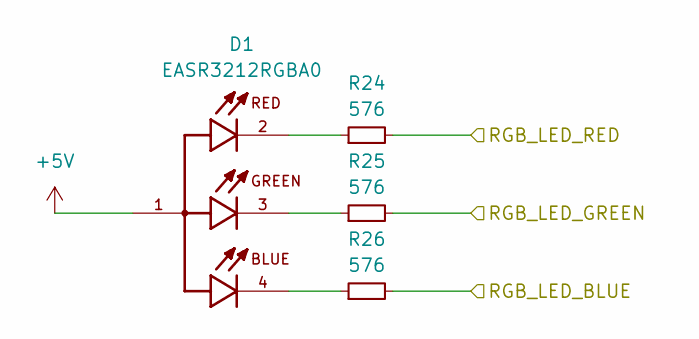
[picture p21: schematic RGB LED Onboard.kicad_sch]

Parts:
D1: EASR3212RGBA0; LED_EASR3212RGBA0; PARTREV 4
R24, R25, R26: 576; R_0402_1005Metric_Pad0.72x0.64mm_HandSolder

Connections:
+5V: D1.1
unnamed: D1.2, R24.1
unnamed: D1.3, R25.1
unnamed: D1.4, R26.1
RGB_LED_BLUE: R26.2
RGB_LED_GREEN: R25.2
RGB_LED_RED: R24.2
