Fiat-Anw/FMU_schematic_design-from-STM32H743IIT6/FMU_Base_board_Design/SPI_PORT.kicad_sch

## KiCad design FMU_Base_board_Design/SPI_PORT.kicad_sch (2024-08-14)

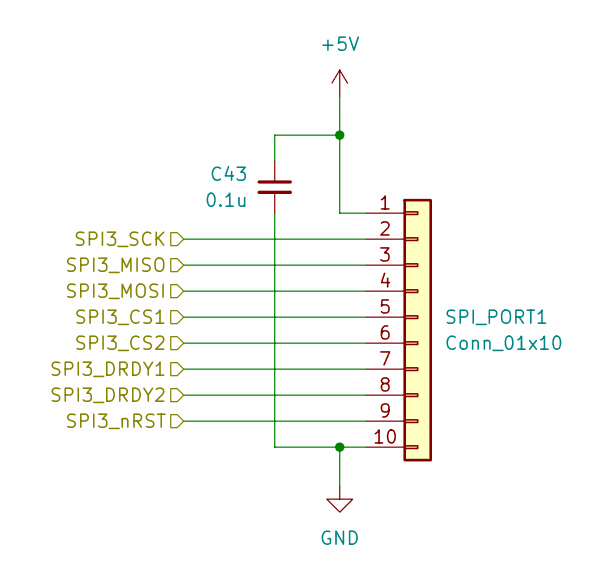
[picture p22: schematic SPI_PORT.kicad_sch]

Parts:
C43: 0.1u; C_0402_1005Metric_Pad0.74x0.62mm_HandSolder
SPI_PORT1: Conn_01x10; JST_GH_BM10B-GHS-TBT_1x10-1MP_P1.25mm_Vertical

Connections:
+5V: C43.1, SPI_PORT1.1
GND: C43.2, SPI_PORT1.10
SPI3_CS1: SPI_PORT1.5
SPI3_CS2: SPI_PORT1.6
SPI3_DRDY1: SPI_PORT1.7
SPI3_DRDY2: SPI_PORT1.8
SPI3_MISO: SPI_PORT1.3
SPI3_MOSI: SPI_PORT1.4
SPI3_SCK: SPI_PORT1.2
SPI3_nRST: SPI_PORT1.9
