Fiat-Anw/FMU_schematic_design-from-STM32H743IIT6/FMU_Base_board_Design/Telemetry_PORT1.kicad_sch

## KiCad design FMU_Base_board_Design/Telemetry_PORT1.kicad_sch (2024-08-14)

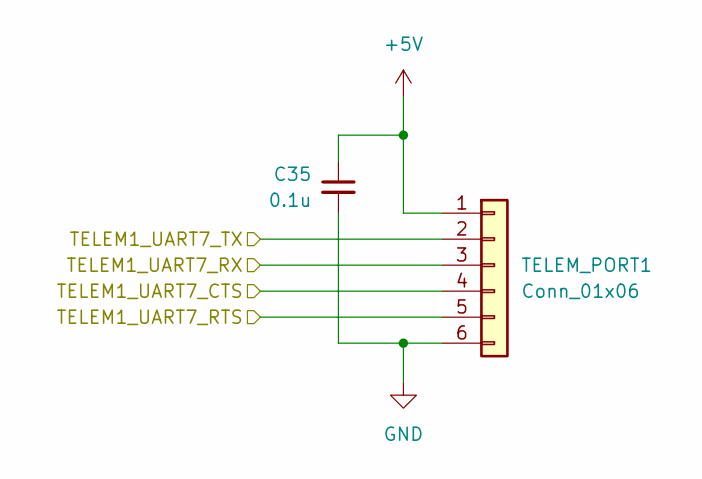
[picture p23: schematic Telemetry_PORT1.kicad_sch]

Parts:
C35: 0.1u; C_0402_1005Metric_Pad0.74x0.62mm_HandSolder
TELEM_PORT1: Conn_01x06; JST_GH_BM06B-GHS-TBT_1x06-1MP_P1.25mm_Vertical

Connections:
+5V: C35.1, TELEM_PORT1.1
GND: C35.2, TELEM_PORT1.6
TELEM1_UART7_CTS: TELEM_PORT1.4
TELEM1_UART7_RTS: TELEM_PORT1.5
TELEM1_UART7_RX: TELEM_PORT1.3
TELEM1_UART7_TX: TELEM_PORT1.2
