Fiat-Anw/FMU_schematic_design-from-STM32H743IIT6/FMU_Base_board_Design/Telemetry_PORT2.kicad_sch

## KiCad design FMU_Base_board_Design/Telemetry_PORT2.kicad_sch (2024-08-14)

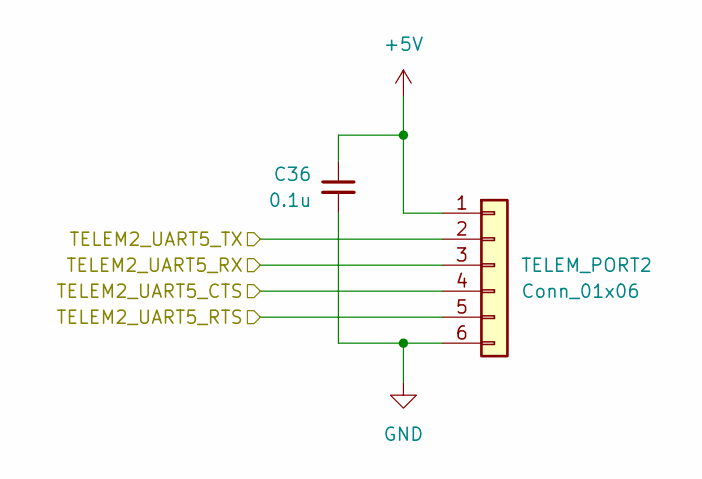
[picture p24: schematic Telemetry_PORT2.kicad_sch]

Parts:
C36: 0.1u; C_0402_1005Metric_Pad0.74x0.62mm_HandSolder
TELEM_PORT2: Conn_01x06; JST_GH_BM06B-GHS-TBT_1x06-1MP_P1.25mm_Vertical

Connections:
+5V: C36.1, TELEM_PORT2.1
GND: C36.2, TELEM_PORT2.6
TELEM2_UART5_CTS: TELEM_PORT2.4
TELEM2_UART5_RTS: TELEM_PORT2.5
TELEM2_UART5_RX: TELEM_PORT2.3
TELEM2_UART5_TX: TELEM_PORT2.2
