Fiat-Anw/FMU_schematic_design-from-STM32H743IIT6/FMU_Base_board_Design/Telemetry_PORT3.kicad_sch

## KiCad design FMU_Base_board_Design/Telemetry_PORT3.kicad_sch (2024-08-14)

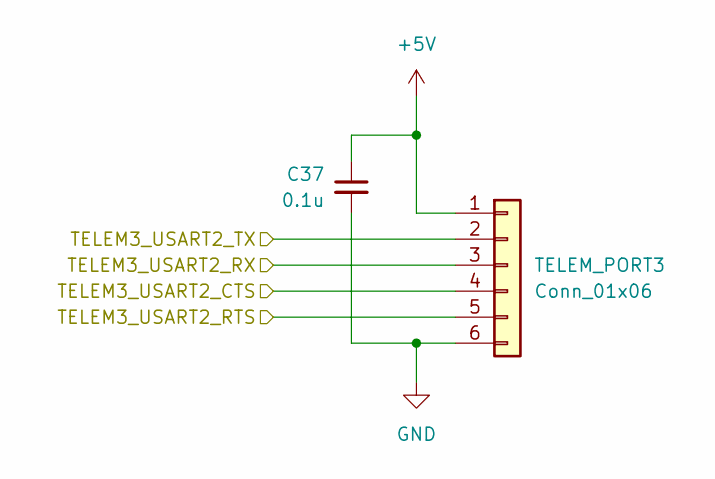
[picture p25: schematic Telemetry_PORT3.kicad_sch]

Parts:
C37: 0.1u; C_0402_1005Metric_Pad0.74x0.62mm_HandSolder
TELEM_PORT3: Conn_01x06; JST_GH_BM06B-GHS-TBT_1x06-1MP_P1.25mm_Vertical

Connections:
+5V: C37.1, TELEM_PORT3.1
GND: C37.2, TELEM_PORT3.6
TELEM3_USART2_CTS: TELEM_PORT3.4
TELEM3_USART2_RTS: TELEM_PORT3.5
TELEM3_USART2_RX: TELEM_PORT3.3
TELEM3_USART2_TX: TELEM_PORT3.2
