Fiat-Anw/FMU_schematic_design-from-STM32H743IIT6/FMU_Base_board_Design/UART4&I2C_PORT.kicad_sch

## KiCad design FMU_Base_board_Design/UART4&I2C_PORT.kicad_sch (2024-08-14)

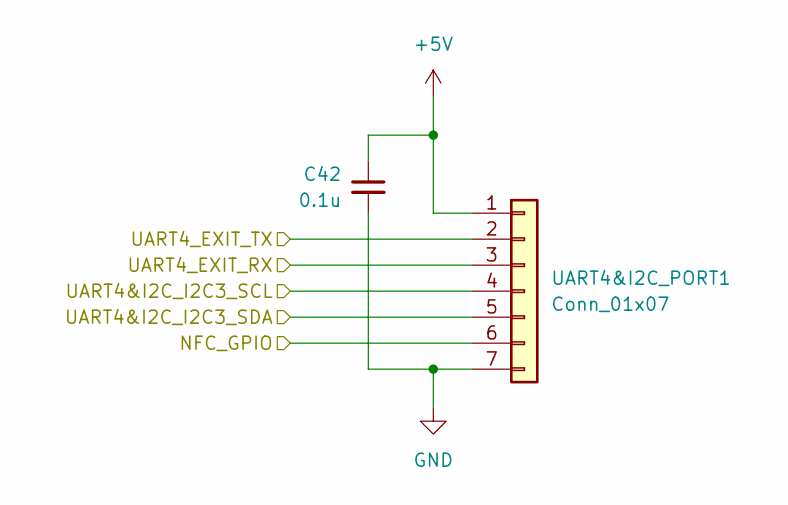
[picture p26: schematic UART4&I2C_PORT.kicad_sch]

Parts:
C42: 0.1u; C_0402_1005Metric_Pad0.74x0.62mm_HandSolder
UART4&I2C_PORT1: Conn_01x07; JST_GH_BM07B-GHS-TBT_1x07-1MP_P1.25mm_Vertical

Connections:
+5V: C42.1, UART4&I2C_PORT1.1
GND: C42.2, UART4&I2C_PORT1.7
NFC_GPIO: UART4&I2C_PORT1.6
UART4&I2C_I2C3_SCL: UART4&I2C_PORT1.4
UART4&I2C_I2C3_SDA: UART4&I2C_PORT1.5
UART4_EXIT_RX: UART4&I2C_PORT1.3
UART4_EXIT_TX: UART4&I2C_PORT1.2
