Fiat-Anw/FMU_schematic_design-from-STM32H743IIT6/FMU_Base_board_Design/USB_Module.kicad_sch

## KiCad design FMU_Base_board_Design/USB_Module.kicad_sch (2024-08-14)

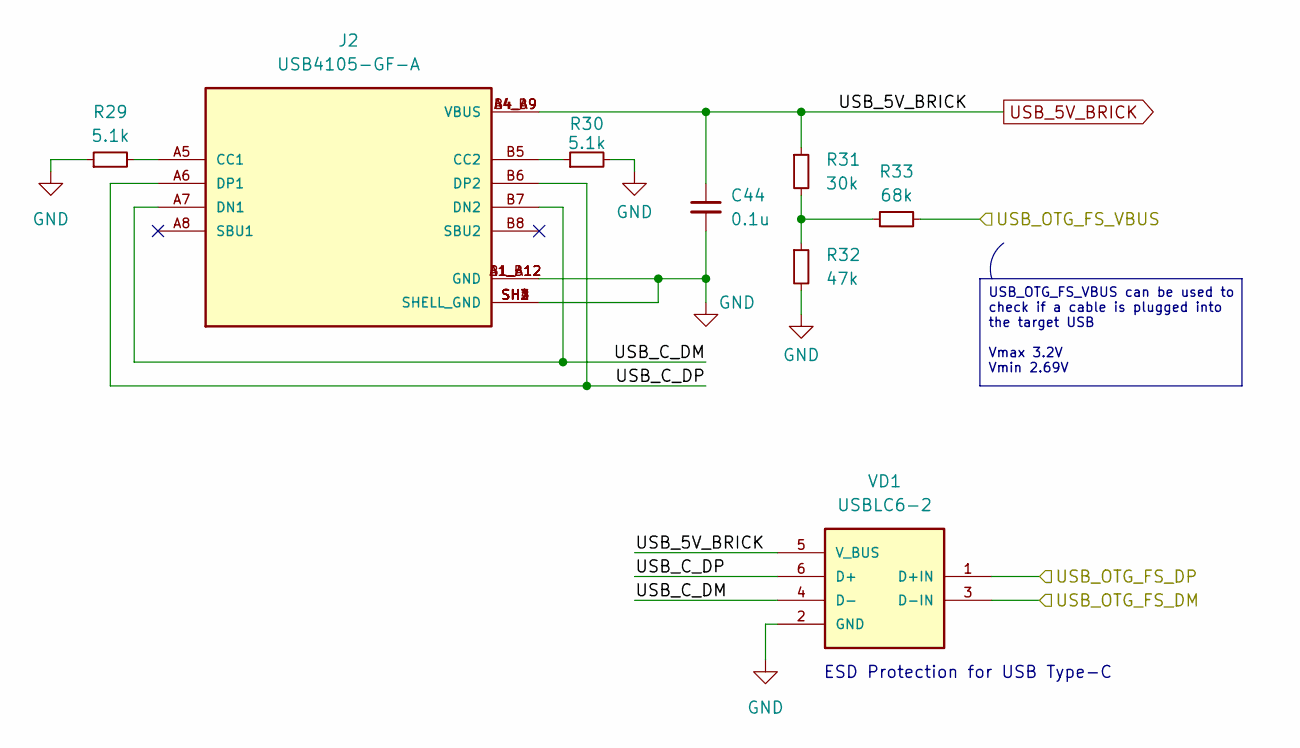
[picture p27: schematic USB_Module.kicad_sch]

Parts:
C44: 0.1u; C_0402_1005Metric_Pad0.74x0.62mm_HandSolder
J2: USB4105-GF-A; GCT_USB4105-GF-A; PARTREV B3
R29, R30: 5.1k; R_0402_1005Metric_Pad0.72x0.64mm_HandSolder
R31: 30k; R_0402_1005Metric_Pad0.72x0.64mm_HandSolder
R32: 47k; R_0402_1005Metric_Pad0.72x0.64mm_HandSolder
R33: 68k; R_0402_1005Metric_Pad0.72x0.64mm_HandSolder
VD1: USBLC6-2; SOT23-6L

Connections:
GND: C44.2, J2.A1_B12 (GND), J2.B1_A12 (GND), J2.SH1 (SHELL_GND), J2.SH2 (SHELL_GND), J2.SH3 (SHELL_GND), J2.SH4 (SHELL_GND), R29.1, R30.2, R32.2, VD1.2 (GND)
unnamed: J2.A5 (CC1), R29.2
unnamed: J2.B5 (CC2), R30.1
unnamed: R31.2, R32.1, R33.1
USB_5V_BRICK: C44.1, J2.A4_B9 (VBUS), J2.B4_A9 (VBUS), R31.1, VD1.5 (V_BUS)
USB_C_DM: J2.A7 (DN1), J2.B7 (DN2), VD1.4 (D-)
USB_C_DP: J2.A6 (DP1), J2.B6 (DP2), VD1.6 (D+)
USB_OTG_FS_DM: VD1.3 (D-IN)
USB_OTG_FS_DP: VD1.1 (D+IN)
USB_OTG_FS_VBUS: R33.2

Notes on the sheet:
USB_OTG_FS_VBUS can be used to check if a cable is plugged into the target USB Vmax 3.2V Vmin 2.69V
ESD Protection for USB Type-C
